X-lanni/Tinker/1.Bom/README.md

# Tinker
## _Flexible, and Ready to Move: Your Cartoon-Style Bipedal Robot!_ 
Tinker is primarily built using 3D printing and carbon fiber cutting. To ensure structural rigidity, some parts use aluminum alloy cuts. The entire robot runs on 24V power and can be manually assembled. You can process the Tinker kit based on the list below or purchase a pre-assembled kit from the official RoboHome store:  
[Official RoboHome Store](https://shop124436104.taobao.com/?spm=pc_detail.29232929/evo365560b447257.shop_block.dshopinfo.2e687dd6BnZIzR)

## Material List

| Item | Specification | Link | Price (RMB) |
|---|---|---|---|
| Router | Black 1 Ethernet port + PFC antenna | https://item.taobao.com/item.htm?id=636099840850&spm=a1z10.1-c-s.w4004-22912785476.34.28113d0etvlbTQ | 82 |
| Handle<br> | Color classification: diameter 20 hole distance 75MM silver | https://detail.tmall.com/item.htm?id=648984641196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.. | 25 |
| Handle 1 | 100mm spacing | https://detail.tmall.com/item.htm?id=649810911512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 | 12.5 |
| Battery | Color classification: 6s1865:24v7ah rectangular/38-70-110 mm<br> | https://item.taobao.com/item.htm?id=620559361552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 | 199 |
| DCDC | 7.4V | https://item.taobao.com/item.htm?_u=31klsj89a707&id=601763884843&spm=a1z09.2.0.0.35152e8dtsNMeP | 42 |
| DCDC | 5V | https://item.taobao.com/item.htm?_u=31klsj89a707&id=601763884843&spm=a1z09.2.0.0.35152e8dtsNMeP | 42 |
| 6006 motor | 4 of them. | https://item.taobao.com/item.htm?id=816922353459&spm=a21xtw.29178619.product_shelf.8.4e127fe0pb8Ghr | 799 |
| 8006 motor | 6 of them. | https://item.taobao.com/item.htm?id=815097170248&spm=a21xtw.29178619.product_shelf.15.4e127fe0pb8Ghr | 1009 |
| Robot main controller<br> | 1 | https://item.taobao.com/item.htm?id=643604114830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 | 899 |
| Jumper conversion module | 1.USB 2.0 female socket to DIP<br> | https://detail.tmall.com/item.htm?id=520458685405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 | 15 |
| Distribution board | 1 | With step-down module | 200 |
| Carbon fiber cutting | 1 set | See below | Inquiry |
| Aluminum alloy processing | 1 set | See below | Inquiry |
| 3D printing | 1 set | See below | Inquiry |
| TF card | 64G 2 pieces<br> | https://detail.tmall.com/item.htm?id=44499258098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 | 32 |
| Servo brushlessSCS40 | 2 | https://item.taobao.com/item.htm?id=561810277224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 | 386 |
| Steering gear SCS125(Can be upgraded to 40 to improve head flexibility) | 1 | https://item.taobao.com/item.htm?id=648615972680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 | 85 |
| Steering gear drive plate | 1 | https://item.taobao.com/item.htm?id=560546097733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 | 45 |
| JetsonNano | Single main board | https://detail.tmall.com/item.htm?id=608609593274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 | 1119 |
| Network cable | 3.Length: 0.25m Color Classification: Upper Bend, Super Category 6 Thin Line | https://detail.tmall.com/item.htm?id=624570157854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 | 6.8 |
| Remote control | 1.Bat 2 black [high-end version] with vibration | https://detail.tmall.com/item.htm?id=38896089959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 | 77 |
| Ethernet port conversion | Shielded D-type straight-through socket (1 piece) | https://detail.tmall.com/item.htm?id=674427182363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 | 20.8 |
| Sleeve | Black large size (adult size) [ (length 33 width 20cm) ] 2 pieces | https://item.taobao.com/item.htm?id=683955453468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 | 13 |
| Foot cushioning | Thick 15 wide 40 | https://detail.tmall.com/item.htm?id=740214426088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 | 11 |
| Air switch | Single 32A | https://buyertrade.taobao.com/trade/detail/tradeSnap.htm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 | 31 |
| Pressure reduction module | 5V | https://item.taobao.com/item.htm?id=544179516749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 | 23 |

## Screw and Nut

| Screen | Link | Number | Usage |
|---|---|---|---|
| M3*6<br> | https://detail.tmall.com/item.htm?id=635430936636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 | 20 | Top motor mounting |
| M3*6 | | 10 | Fixed aluminum alloy for rolling motor |
| M4*8 | | 10 | Fixed aluminum alloy for rolling motor |
| M4*8 | | 10 | Thigh aluminum roll motor |
| M4*8 | | 10 | Thigh aluminum alloy thigh motor |
| M3*6 | | 28 | Thigh carbon plate |
| M3*10 | | 6 | Thigh carbon plate and support |
| M4*6 | | 10 | Calf carbon plate, calf motor |
| M3*10 | | 8 | Calf carbon plate and support |
| M3*6 | | 10 | Ankle joint motor and carbon plate |
| M3*8 | | 12 |  Ankle joint motor and foot end |
| M3*15 | | 8 |  Upper and lower racks and supports |
| M3*10 | | 6 | Battery compartment |
| M5*15 | | 4 | Bottom support |
| M3*12 | | 2 | Battery top fixing |
| M3*10 | | 4 | Battery side fixing |
| M3*6 | | 4 |  Main control carbon plate support |
| M3*8 | |  4 |  Power supply plate fixing |
| M2.5 aluminum column * 12 | https://item.taobao.com/item.htm?id=521616041424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  | 4 | Main control plate support |
| M2.5*5 | https://item.taobao.com/item.htm?id=521623593151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..  | 4 | Main control carrier board |
| M2.5*10 | |  4 | Main control carrier bottom |
| M3*12 | |  4 |  JetsonNano |
| M3*10 | |  8 |  Router, servo drive |
| M4*15 | | 10 | Head servo fixation |
| M3*8 | | 15 | Head servo |
| M3 nut self-locking | https://item.taobao.com/item.htm?id=9558815975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 | Above sum | |
| | | | |

## Cable
| Type | Link | Number |
|---|---|---|
| Red and black power extension cable16AW | https://item.taobao.com/item.htm?id=597502950509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 | 2 meters |
| XT30 female head16AW<br> | https://item.taobao.com/item.htm?id=598407253999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 | 8 |
| XT30 male head16AW | |8 |
| 4P 2.0 line | https://item.taobao.com/item.htm?id=520551443113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. | 6 |
| 4P 1.25 line 20cm | https://item.taobao.com/item.htm?id=588775918268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 | 4 |
| Double head 10cm 4p Same face | https://detail.tmall.com/item.htm?id=550579148901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 | 2 |
| Double head 10cm 4p different surface | | 2 |
| DC head 0.1m | https://detail.tmall.com/item.htm?id=598354258377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 | 2 |

## Carbon fiber cutting
V1：[Click here to view the folder](https://drive.google.com/drive/folders/1KnC-RKWRdck51djY4cLO2_fAsvc746Mc?usp=drive_link)

Carbon plate cutting includes the following content, among which the marked X needs to be processed according to the number, and the last two need to be cut 0.5mm on each side to ensure installation:
<div align="center">


</div>
<div align="center">

</div>

## Aluminum alloy processing
V1：[Click here to view the folder](https://drive.google.com/drive/folders/1Rvp5F-ukXmW73BvD4d4sHrTAwg58c-pP?usp=drive_link)

Aluminum alloy processing is as follows: hip processing 2, thigh processing according to symmetry 1 positive and 1 negative 2
<div align="center">

</div>

## 3D printing
V1: [Click here to view the folder](https://drive.google.com/drive/folders/12IBDAVzblmIEFn6BoeleFhU9YEcTEuLw?usp=drive_link)

3D printing processing is as follows: DC represents the need to print 1 positive and 1 negative, and the corresponding number of other numbers marked separately:
<div align="center">

</div>

## PCB processing (optional)
V1：[Click here to view the folder](https://drive.google.com/drive/folders/1OVtjc0a6-6FSMaonkhxavuNPwOWzWQmY?usp=drive_link)

PCB processing includes the following, and controller kits can also be purchased directly from [RoboHome](https://item.taobao.com/item.htm?id=643604114830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)
<div align="center">

</div>
