X-lanni/Tinker/2.Assemble/Hardware/pcb原理图/PCB-20241204T155450Z-001/PCB/人形分电.PcbDoc.htm

Reporting Options

# File in Previous Format

Date | : | 2024/12/4
Time | : | 23:57:12
Filename | : | D:\GitHub_Project\Tinker\assemble\结构\pcb原理图\PCB-20241204T155450Z-001\PCB\人形分电.PcbDoc

Version | Warning
Release 12 | CAUTION - Air Gap Width previously controlled by Clearance rule is now controlled by Polygon Connect Style rule's newly introduced Air Gap Width (set to default value). Suggest reviewing each Polygon Connect Style rule's Air Gap Width attribute for correctness.
Release 13 | CAUTION - Silkscreen Over Component Pads Rules are converted to Silk To Solder Mask Clearance Rules. Suggest examining rule scopes for accuracy.

This file was generated by an earlier version of the software
