X-lanni/Tinker/4.Development/LocomotionWithNP3O-masteroldx/lcm/lcm-java/jchart2d-code/doc/img/architecture.png

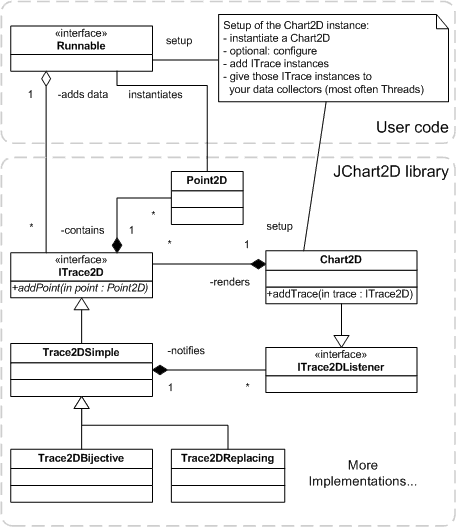
4.Development/LocomotionWithNP3O-masteroldx/lcm/lcm-java/jchart2d-code/doc/img/architecture.png
