X-lanni/Tinker/4.Development/LocomotionWithNP3O-masteroldx/lcm/lcm-java/jchart2d-code/doc/img/Client-Screenshot.gif

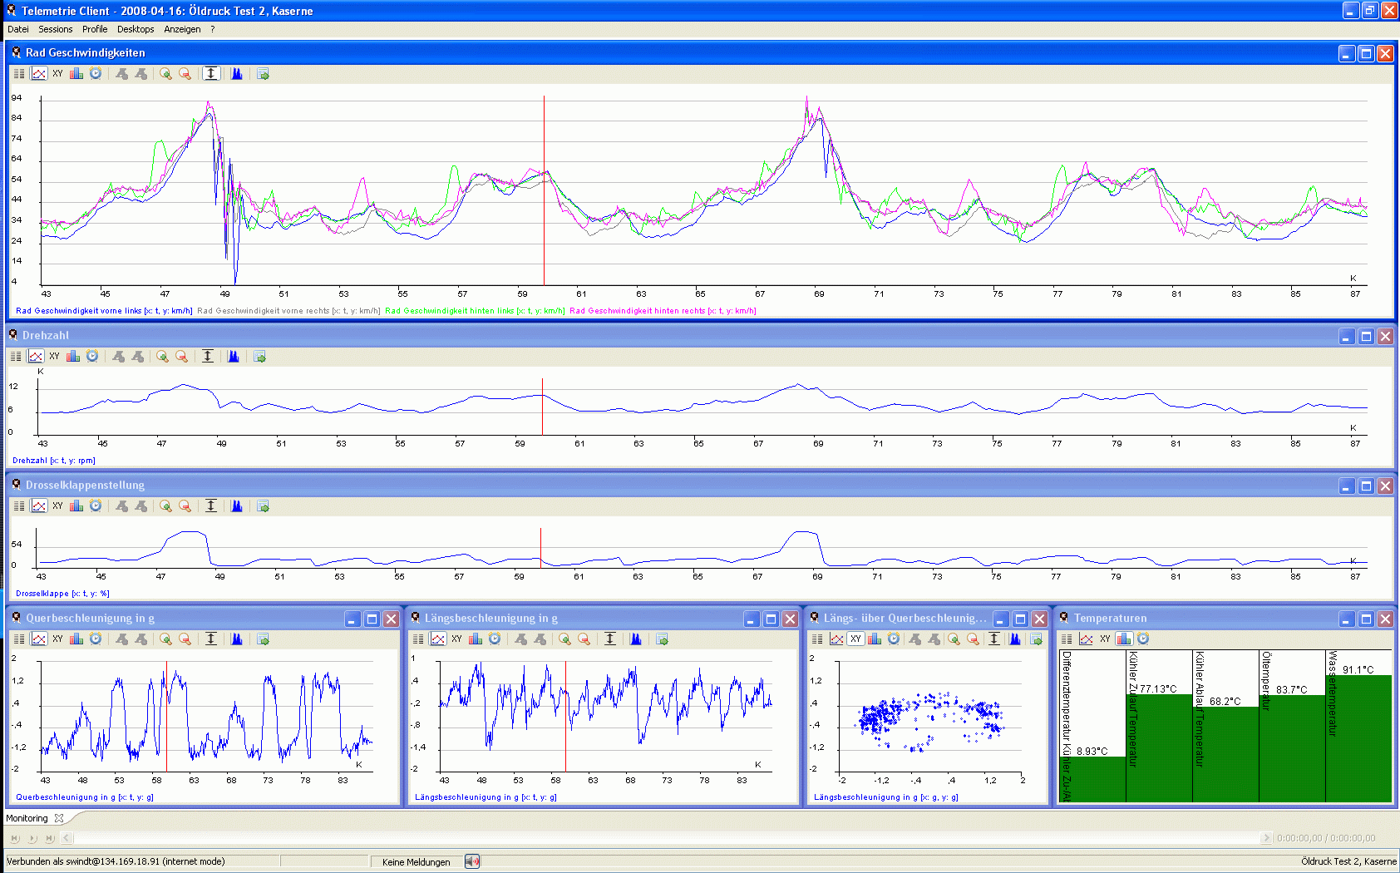
4.Development/LocomotionWithNP3O-masteroldx/lcm/lcm-java/jchart2d-code/doc/img/Client-Screenshot.gif
