X-lanni/Tinker/4.Development/LocomotionWithNP3O-masteroldx/lcm/lcm-java/jchart2d-code/doc/img/saison_2008_lr08_fahrwerk_001_1_20080530_1194722016.jpg

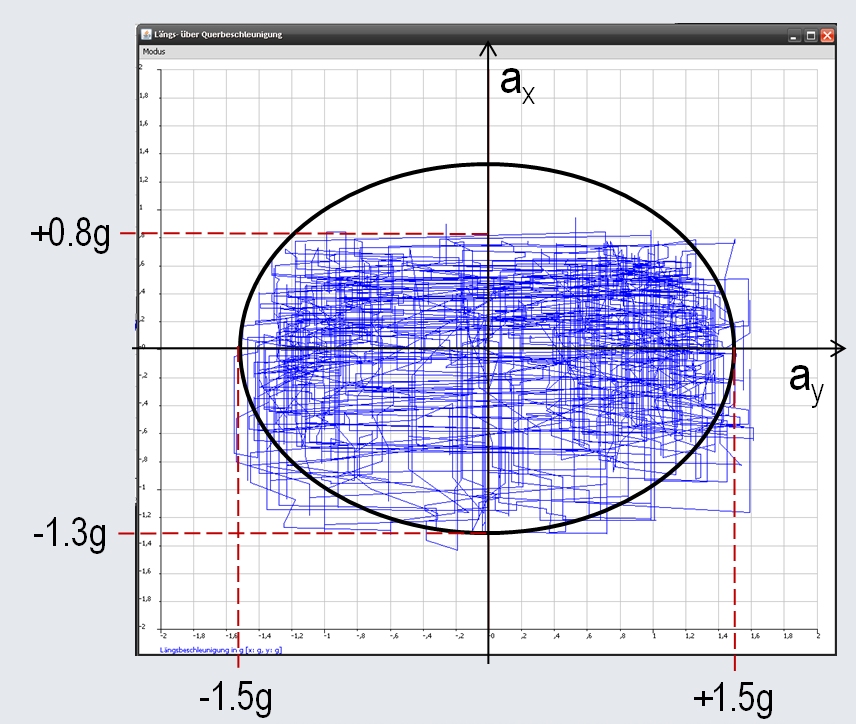
4.Development/LocomotionWithNP3O-masteroldx/lcm/lcm-java/jchart2d-code/doc/img/saison_2008_lr08_fahrwerk_001_1_20080530_1194722016.jpg
