X-lanni/Tinker/5.Docs/images/0/whiteboard_ug1.png

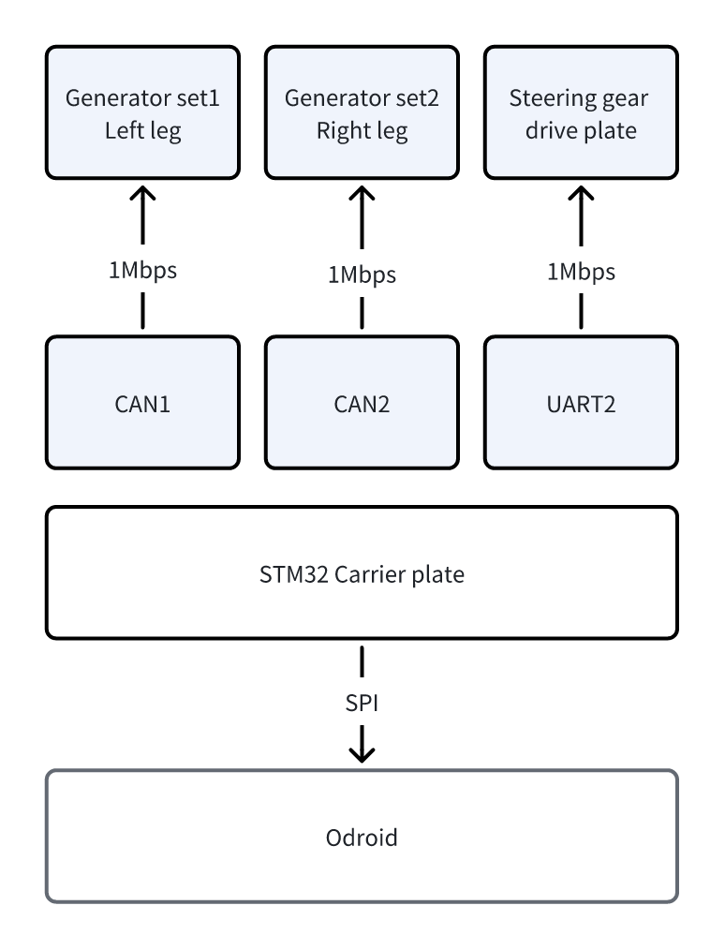
5.Docs/images/0/whiteboard_ug1.png
