X-lanni/Tinker/5.Docs/images/development/1.PNG

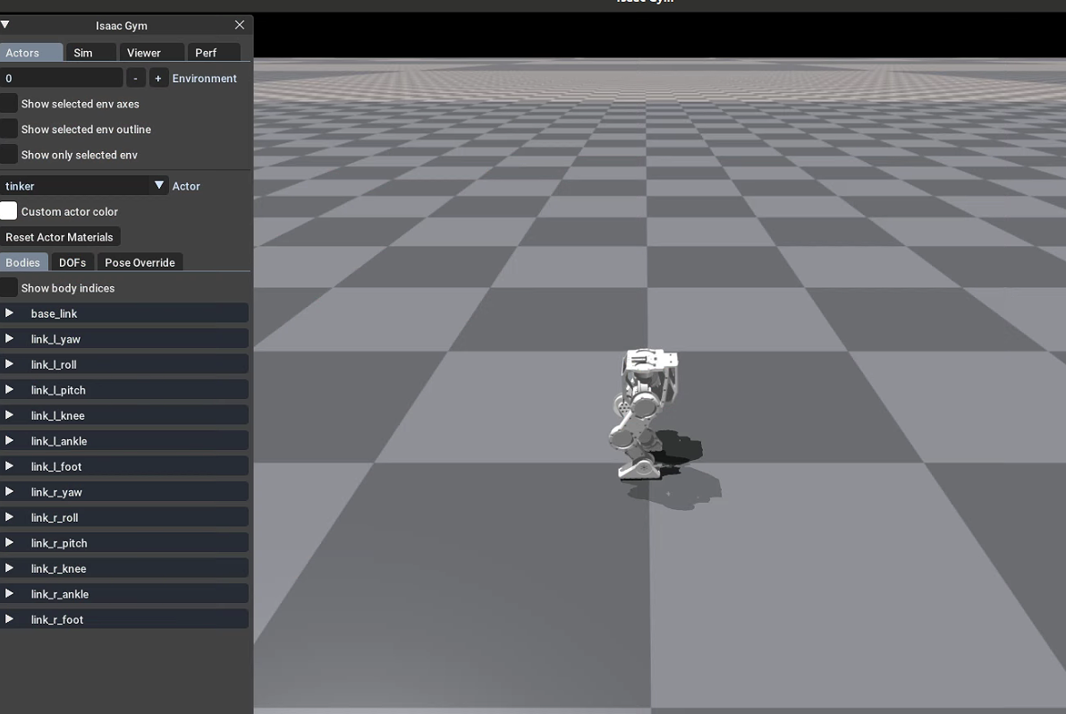
5.Docs/images/development/1.PNG
