X-lanni/Tinker/5.Docs/images/development/2.PNG

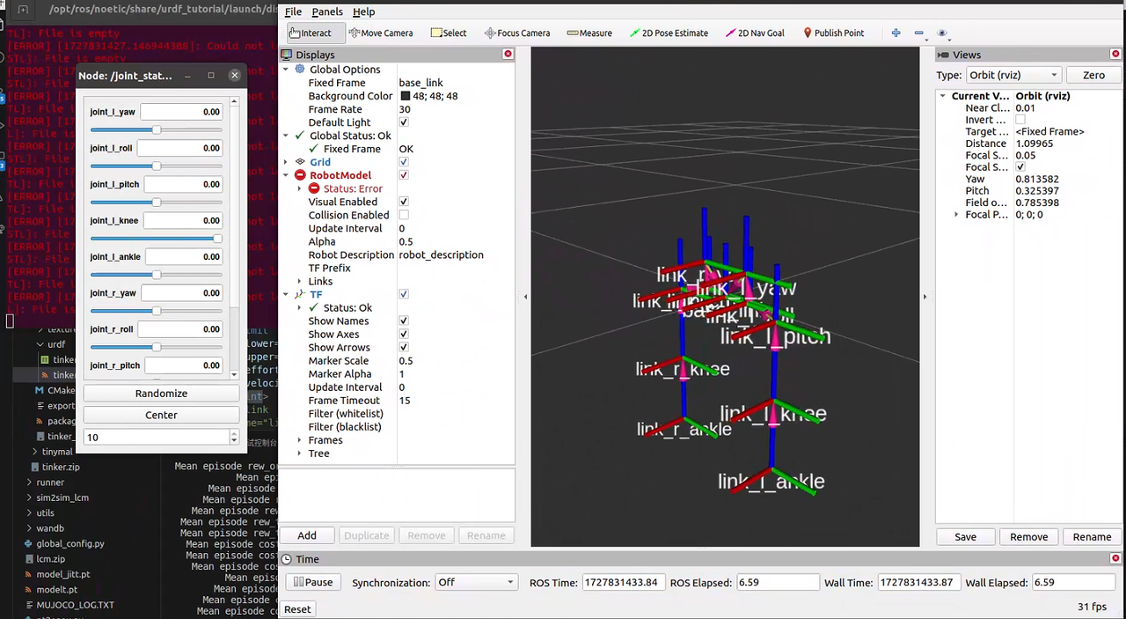
5.Docs/images/development/2.PNG
