X-lanni/Tinker/5.Docs/images/development/3.png

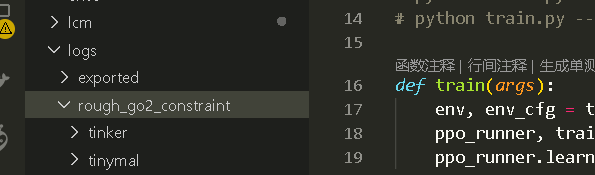
5.Docs/images/development/3.png
