X-lanni/Tinker/5.Docs/images/development/4.png

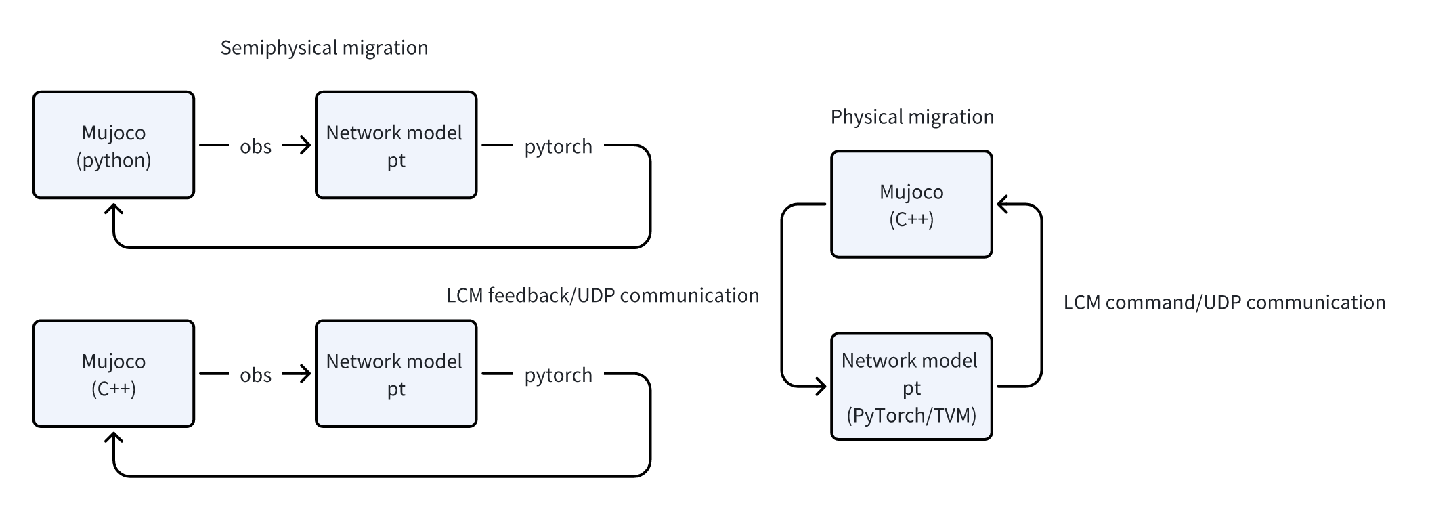
5.Docs/images/development/4.png
