X-lanni/Tinker/5.Docs/images/development/5.png

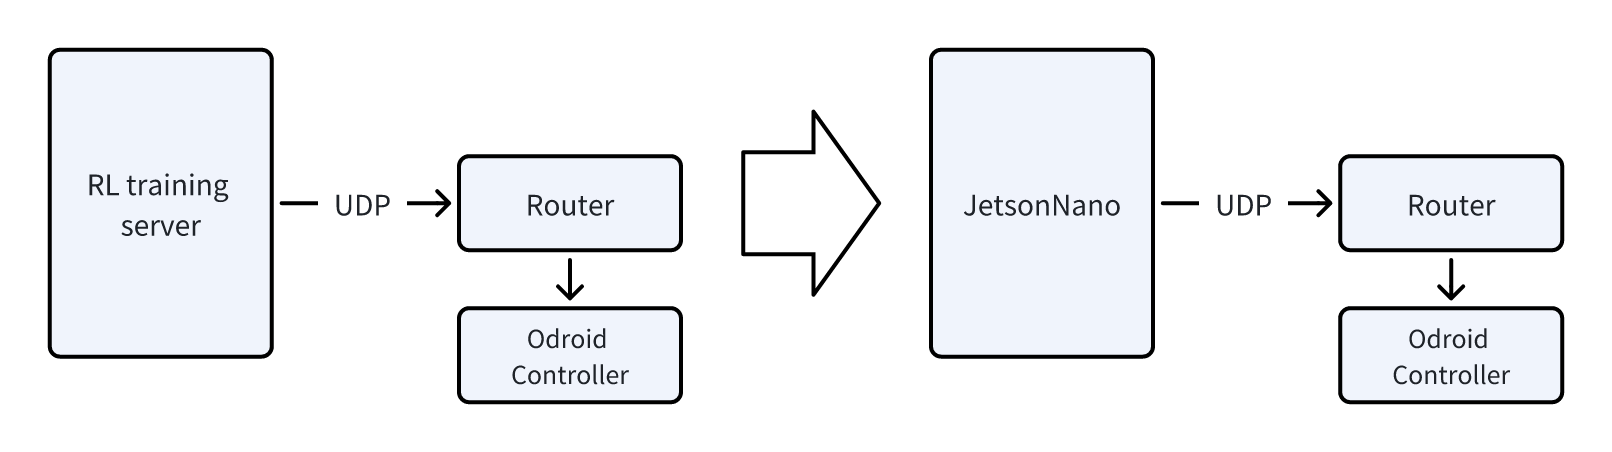
5.Docs/images/development/5.png
