X-lanni/Tinker/5.Docs/images/t01.JPG

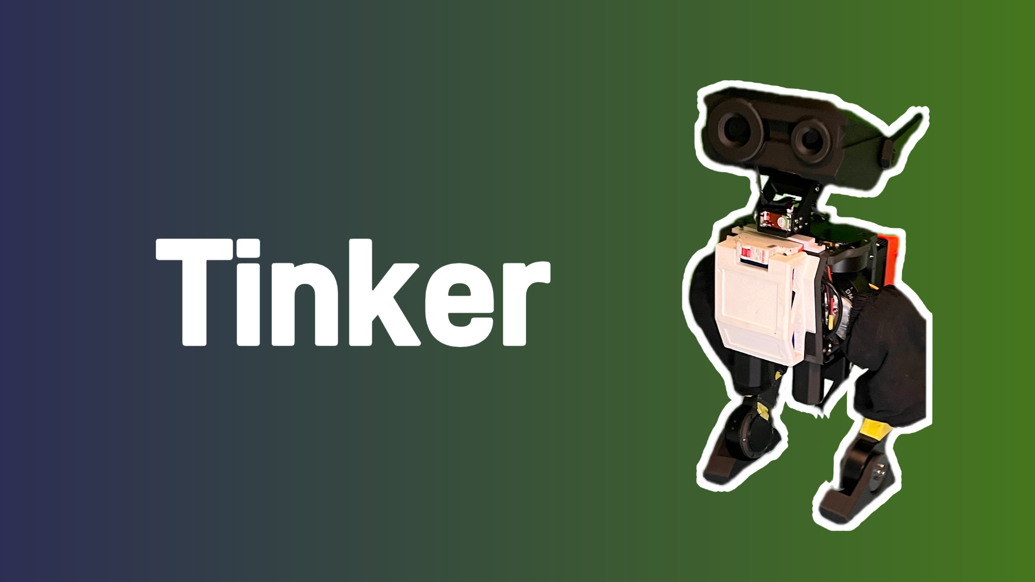
5.Docs/images/t01.JPG
