X-lanni/Tinker/5.Docs/images/videos/24fp.png

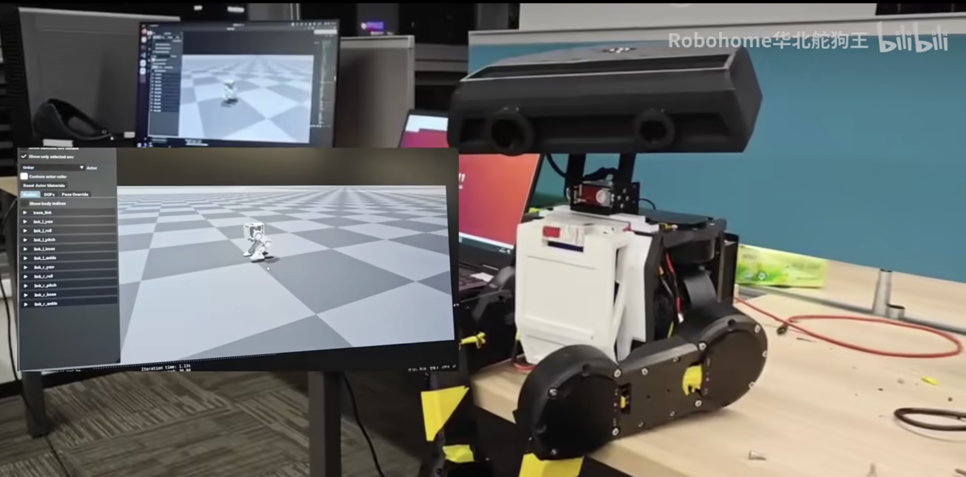
5.Docs/images/videos/24fp.png
