X-lanni/Tinker/2.Assemble/Hardware/pcb原理图/PCB-20241204T155450Z-001/PCB/人形分电.xls

Comment | Description | Designator | Footprint | Quantity
Header 2 | BAT1为母头 其他为公头 | BAT1, BAT2, BAT3, BAT4, BAT5, LEG1, LEG2, LEG3, LEG4 | XT30UPB | 9
Header 2X2 | 2.54排针 | DCDC1, DCDC2 | DCDC5V | 2
LED1 | LED红色 | DS2 | SMDLED | 1
100K | 0603 | R1 | R0805 | 1
560R | 0603 | R2 | R0603 | 1
10K | 0603 | R3 | R0805 | 1
