X-lanni/Tinker/2.Assemble/Hardware/pcb原理图/PCB-20241204T155450Z-001/PCB/载板V2.xls

Comment | Description | Designator | Footprint | Quantity
Header 2 | XH2.54卧插端子 带锁 | BAT1 | HDR1X2 | 1
BEEP | 蜂鸣器 | BEEP? | DET402 | 1
Header 2 | 轻触按键 | BOOT1 | 663*4*2.0/2.5mm | 1
0.1UF | 电容 | C1, C9, C11, C12, C14, C15, C16, C17, C18, C21, C24, C25 | C 0402 | 12
1UF | 电容 | C2 | C 0402 | 1
2.2UF | 电容 | C3, C4 | C0603 | 2
10NF | 电容 | C5 | C 0402 | 1
20PF | 电容 | C6, C7 | C 0402 | 2
0.1UF | 电容 | C8, C19, C20 | C0603 | 3
10uF | 电容 | C10, C13 | C0603 | 2
100uF | 电容 | C27 | C0805 | 1
Header 4 | PH2.0立端子 | CAN1, CAN2, CAN3, CAN4 | PH2.0-4SMT | 4
BAT54WS | 单肖特基二极管 | D1 | SOD-323 | 1
PESD1CAN |  | D2, D3 | SOT-23 | 2
Header 3 | 不焊接 | DBUS1, SBUS | HDR1X3 | 2
Header 2X2 | 不焊接 | DCDC1 | DCDC5V | 1
LED1 | LED蓝色 | DS1, DS2 | SMDLED | 2
ICM20602 |  | ICM1 | ICM20602 | 1
Header 4 | 立贴端子 | IDLE1, RADIO1 | JST_GH_V4 | 2
MSK-12D19 | 立开关三档 | KEY | HDR1X3 | 1
Header 5 | 2.54母座 | P2 | HDR1X5 | 1
Header 4 | 2.54母座 | P3 | HDR1X4 | 1
Header 3 | 立贴端子 | P10 | JST_GH_V3 | 1
Header 7X2 | 2.54排针 | PIO | HDR2X7 | 1
S8050 | 8050/BCW846/BCW847 | Q1, Q2 | SOT-23R | 2
10K | 电阻 | R1, R2, R3, R4, R7, R10, R11 | R0603 | 7
560R | 电阻 | R5, R20 | R0603 | 2
1K | 电阻 | R6 | R0603 | 1
100R | 电阻 | R8, R9 | R0603 | 2
120R | 电阻 | R12, R17 | R0603 | 2
100K | 电阻 | R18 | R0805 | 1
10K | 电阻 | R19 | R0805 | 1
360R | 电阻 | R21, R22 | R 0402 | 2
120R | 电阻 | R23 | R 0402 | 1
Header 2 | 侧轻触按钮 | RST | KEY_SAD | 1
Header 4 | 立贴端子 | SWD1, USB_L1 | SH1.0-4P - UP | 2
STM32F405RGT6 |  | U1 | LQFP64_M | 1
W25X16 | W25X16;SST25VF016;MX25L1605 | U2 | W25Q32FVZPIG | 1
TJA1050 |  | U3, U4 | SOP-8 | 2
SP3485 |  | U5 | SOP-8 | 1
RT9193-3.3/LP2985/SPX3819 | 降压IC | V1 | SOT23-5 | 1
8MHZ | Crystal Oscillator | X1 | PXCL | 1
