X-lanni/Tinker/5.Docs/images/bom/b1.jpeg

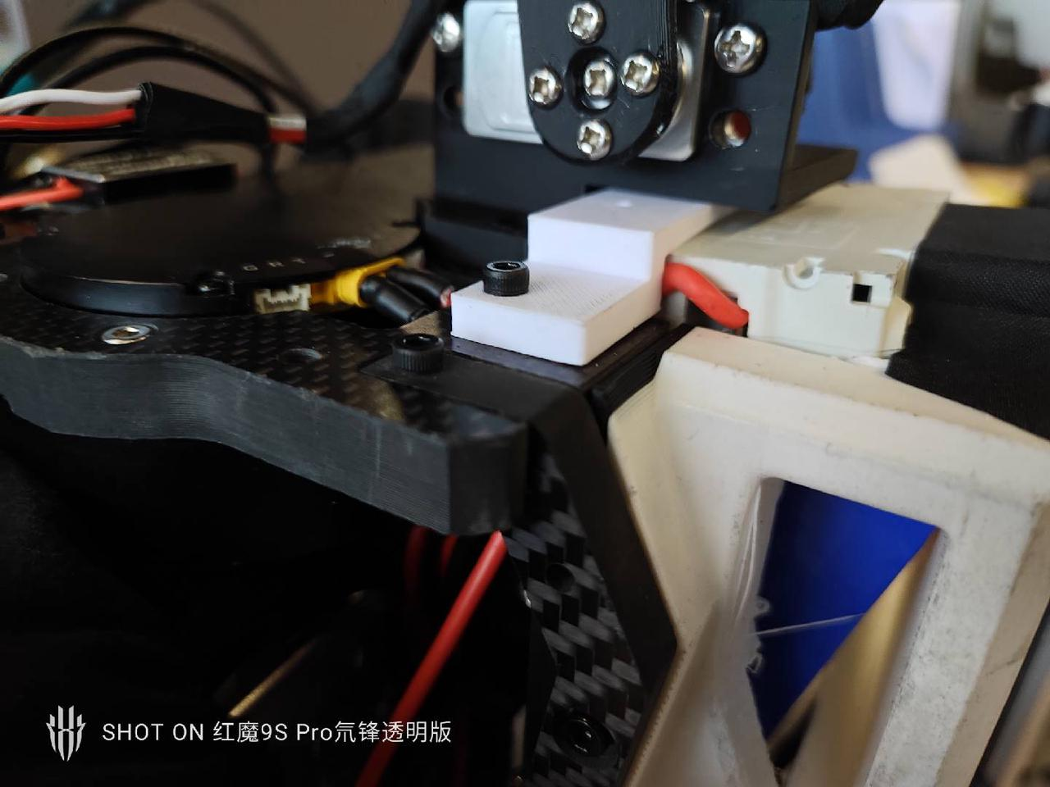
5.Docs/images/bom/b1.jpeg
