X-lanni/Tinker/5.Docs/images/bom/b2.png

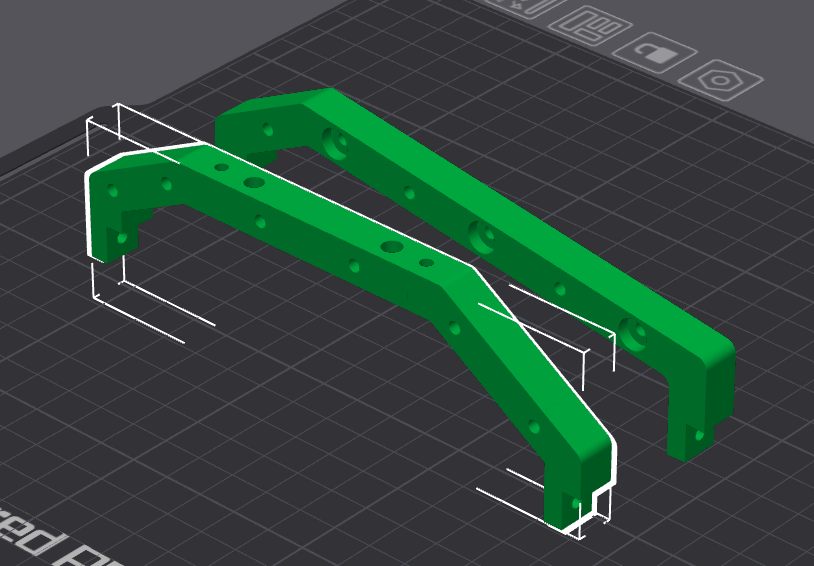
5.Docs/images/bom/b2.png
