X-lanni/Tinker/5.Docs/images/bom/b3.png

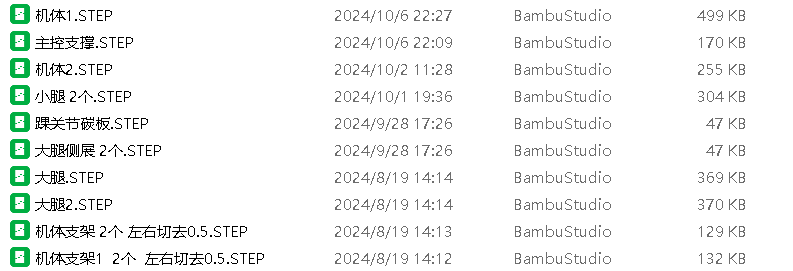
5.Docs/images/bom/b3.png
