X-lanni/Tinker/5.Docs/images/bom/b4.png

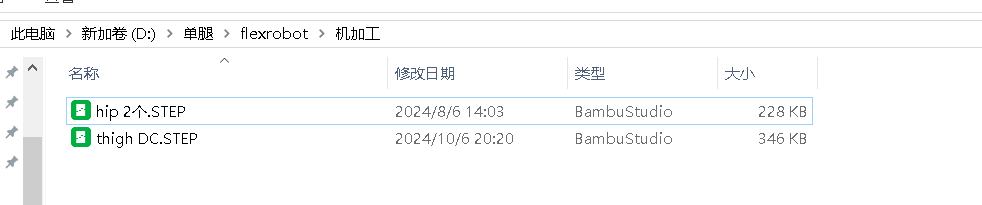
5.Docs/images/bom/b4.png
