X-lanni/Tinker/5.Docs/images/bom/b5.png

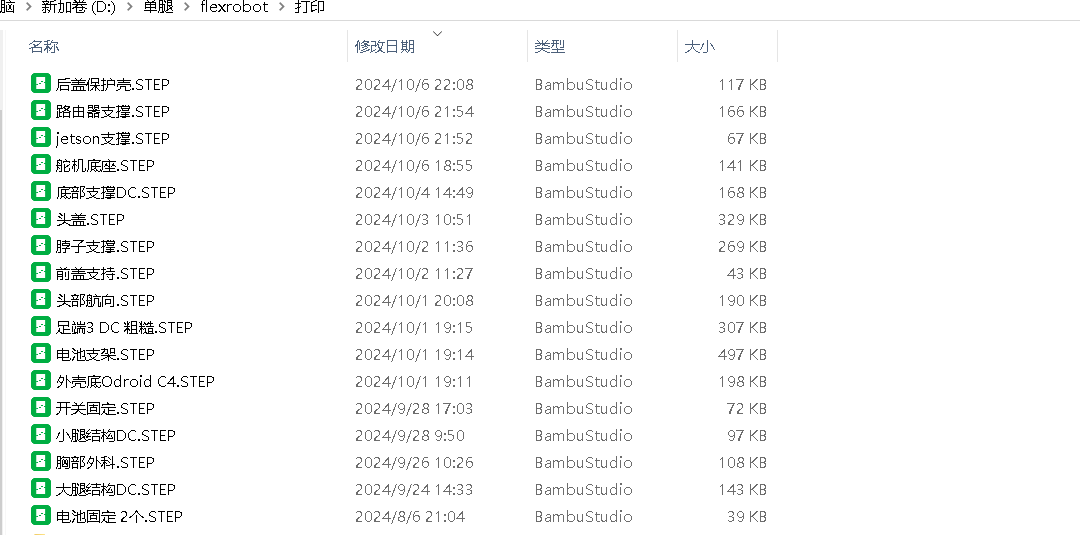
5.Docs/images/bom/b5.png
