X-lanni/Tinker/5.Docs/images/bom/b6.png

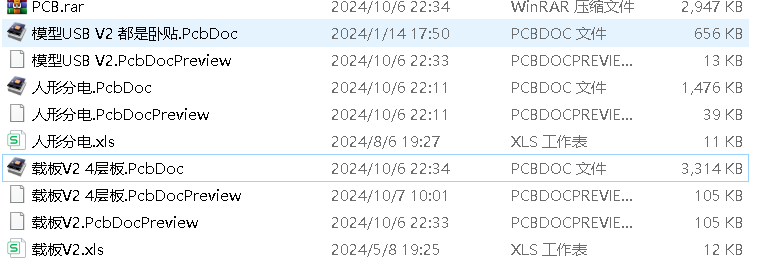
5.Docs/images/bom/b6.png
