X-lanni/Tinker/2.Assemble/Hardware/3d打印件/print-20241204T155423Z-001/print/胸部外科.STEP

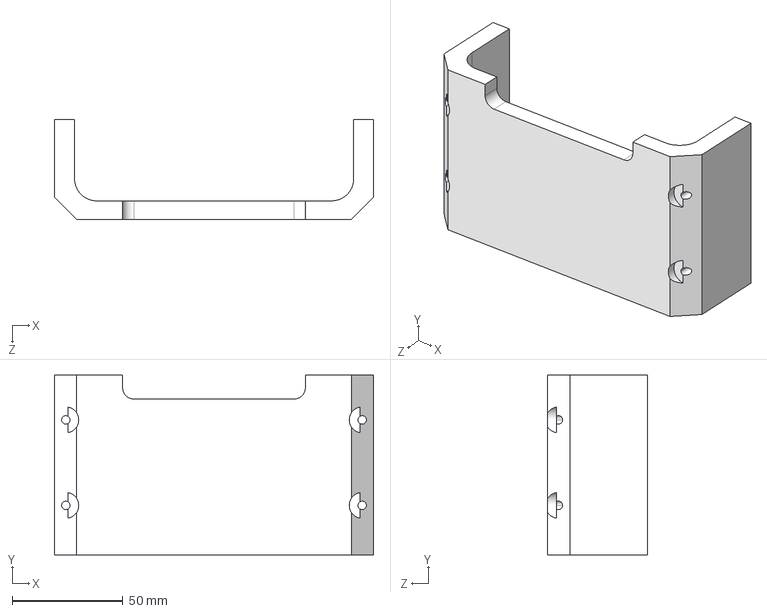
[picture p33: CAD file, 2025-03-02]
2.Assemble/Hardware/3d打印件/print-20241204T155423Z-001/print/胸部外科.STEP
143.8 x 81.1 x 45.0 mm
