X-lanni/Tinker/2.Assemble/Hardware/碳钎维加工/cut-20241204T155151Z-001/cut/小腿 2个.STEP

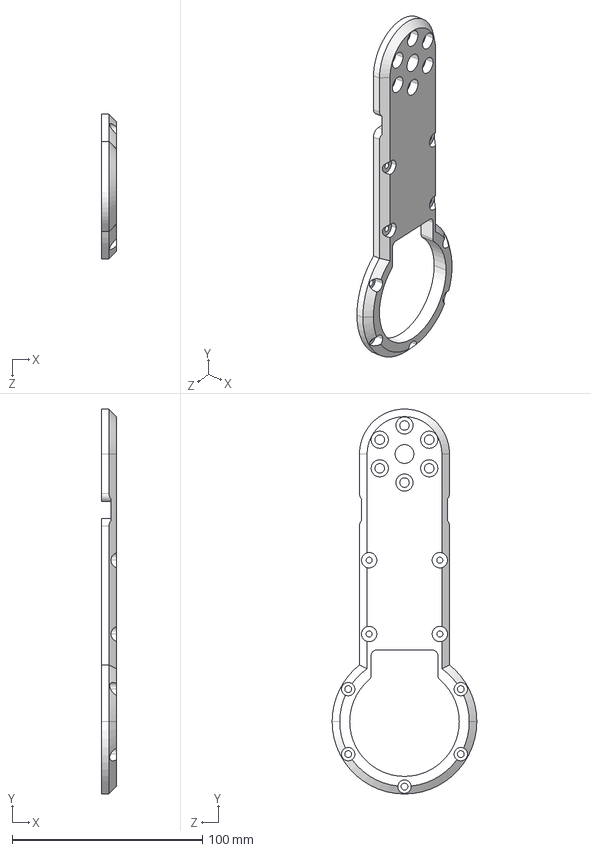
[picture p34: CAD file, 2025-03-02]
2.Assemble/Hardware/碳钎维加工/cut-20241204T155151Z-001/cut/小腿 2个.STEP
8.00 x 202.1 x 76.0 mm
