X-lanni/Tinker/2.Assemble/Hardware/铝合金加工/machining-20241204T155329Z-001/machining/thigh DC.STEP

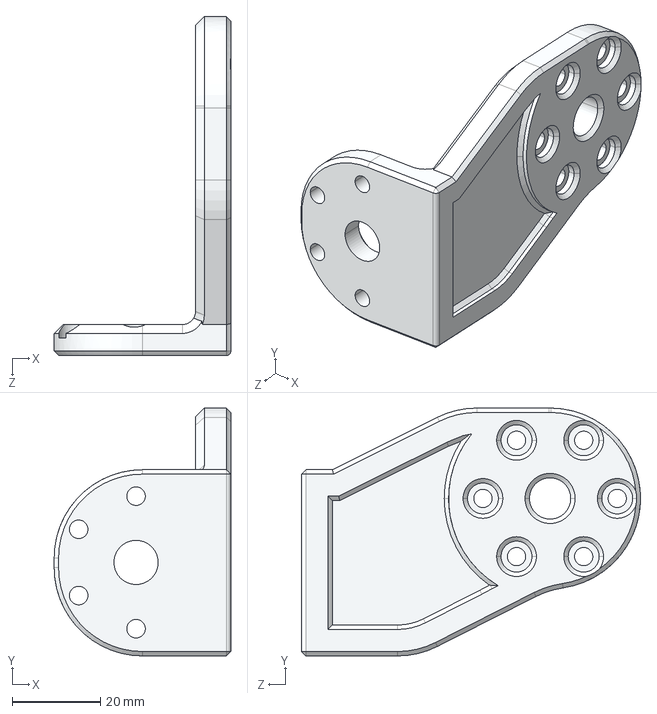
[picture p35: CAD file, 2025-03-02]
2.Assemble/Hardware/铝合金加工/machining-20241204T155329Z-001/machining/thigh DC.STEP
40.0 x 56.1 x 76.7 mm
