X-lanni/Tinker/4.Development/LocomotionWithNP3O-masteroldx/resources/tinker/meshes/base_link.STL

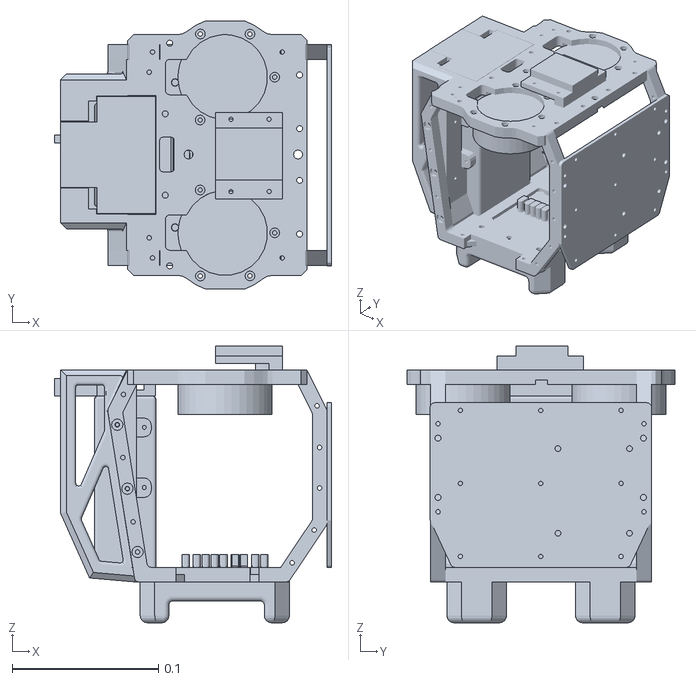
[picture p36: CAD file, 2025-03-02]
4.Development/LocomotionWithNP3O-masteroldx/resources/tinker/meshes/base_link.STL
0.19 x 0.184 x 0.189
