X-lanni/Tinker/4.Development/LocomotionWithNP3O-masteroldx/resources/tinymal/meshes/RR_foot.STL

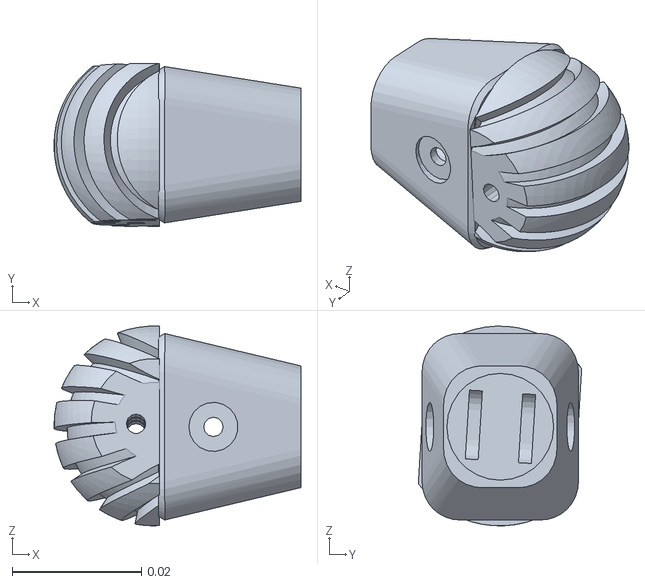
[picture p37: CAD file, 2025-03-02]
4.Development/LocomotionWithNP3O-masteroldx/resources/tinymal/meshes/RR_foot.STL
0.0382 x 0.0252 x 0.0308
