X-lanni/Tinker/4.Development/tinker/meshes/link_l_pitch.STL

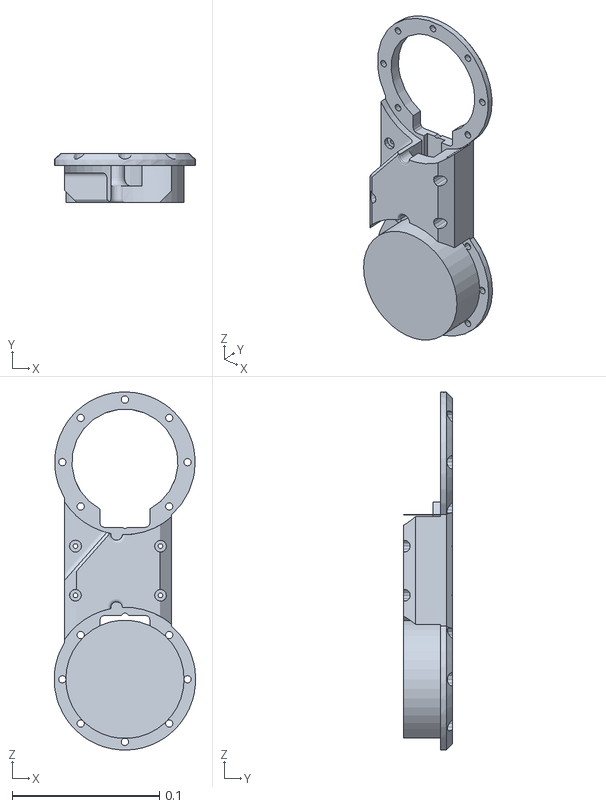
[picture p38: CAD file, 2025-03-02]
4.Development/tinker/meshes/link_l_pitch.STL
0.096 x 0.033 x 0.243
