X-lanni/Tinker/2.Assemble/Hardware/3d打印件/print-20241204T155423Z-001/print/外壳底Odroid C4.STEP

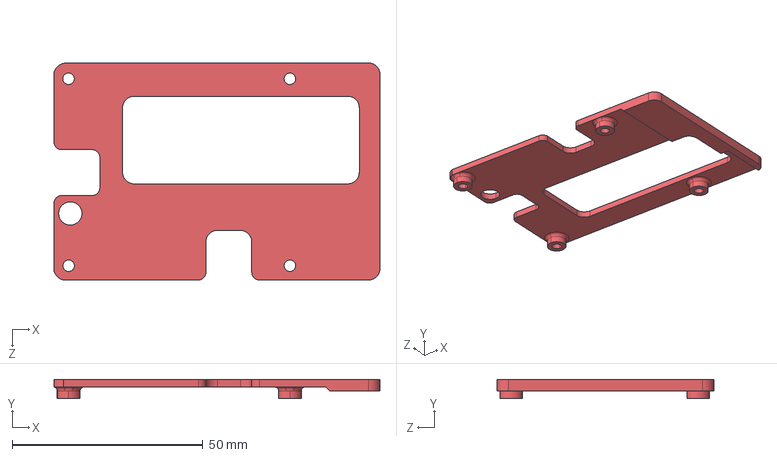
[picture p39: CAD file, 2025-03-02]
2.Assemble/Hardware/3d打印件/print-20241204T155423Z-001/print/外壳底Odroid C4.STEP
85.4 x 5.00 x 56.9 mm
