X-lanni/Tinker/2.Assemble/Hardware/碳钎维加工/cut-20241204T155151Z-001/cut/大腿.STEP

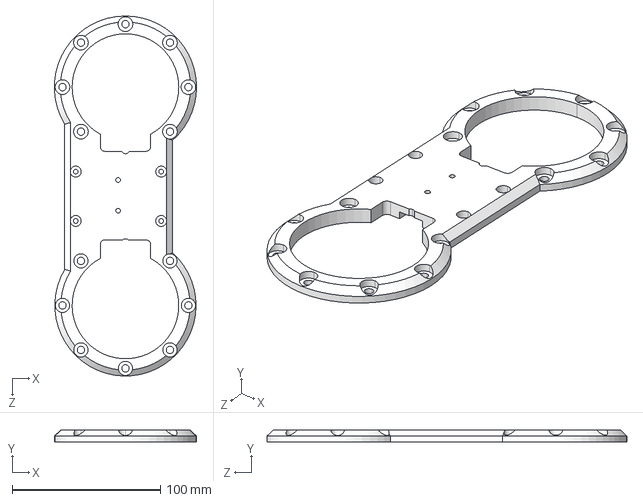
[picture p40: CAD file, 2025-03-02]
2.Assemble/Hardware/碳钎维加工/cut-20241204T155151Z-001/cut/大腿.STEP
96.0 x 8.00 x 243.1 mm
