X-lanni/Tinker/2.Assemble/Hardware/铝合金加工/machining-20241204T155329Z-001/machining/hip 2个.STEP

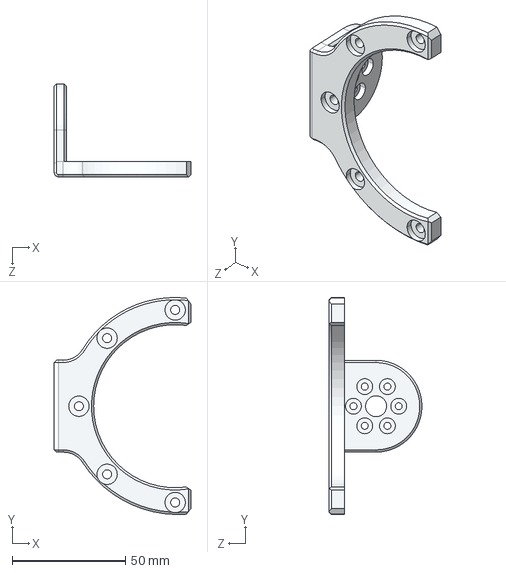
[picture p41: CAD file, 2025-03-02]
2.Assemble/Hardware/铝合金加工/machining-20241204T155329Z-001/machining/hip 2个.STEP
60.3 x 95.8 x 41.0 mm
