X-lanni/Tinker/4.Development/LocomotionWithNP3O-masteroldx/resources/tinker/meshes/link_r_yaw.STL

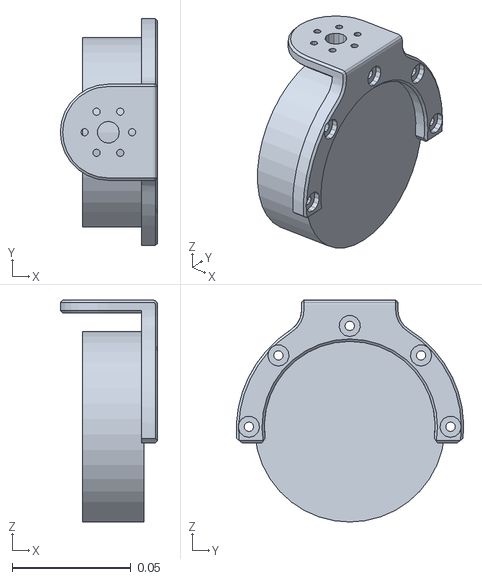
[picture p42: CAD file, 2025-03-02]
4.Development/LocomotionWithNP3O-masteroldx/resources/tinker/meshes/link_r_yaw.STL
0.041 x 0.0958 x 0.0936
