X-lanni/Tinker/4.Development/LocomotionWithNP3O-masteroldx/resources/tinymal/meshes/RR_hip.STL

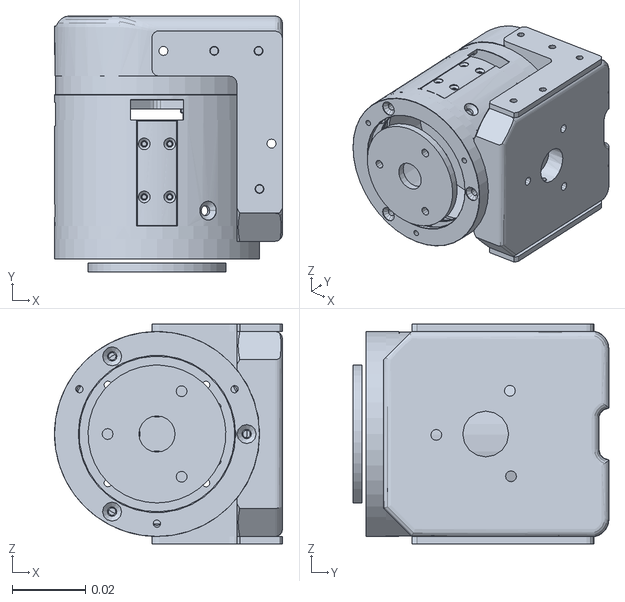
[picture p43: CAD file, 2025-03-02]
4.Development/LocomotionWithNP3O-masteroldx/resources/tinymal/meshes/RR_hip.STL
0.0623 x 0.0699 x 0.06
