X-lanni/Tinker/4.Development/tinker/meshes/link_r_knee.STL

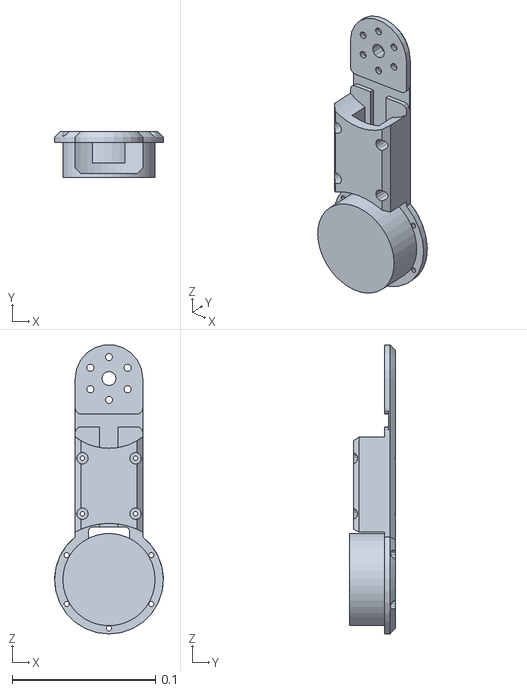
[picture p44: CAD file, 2025-03-02]
4.Development/tinker/meshes/link_r_knee.STL
0.076 x 0.0325 x 0.202
