X-lanni/Tinker/2.Assemble/Hardware/3d打印件/print-20241204T155423Z-001/print/头部航向.STEP

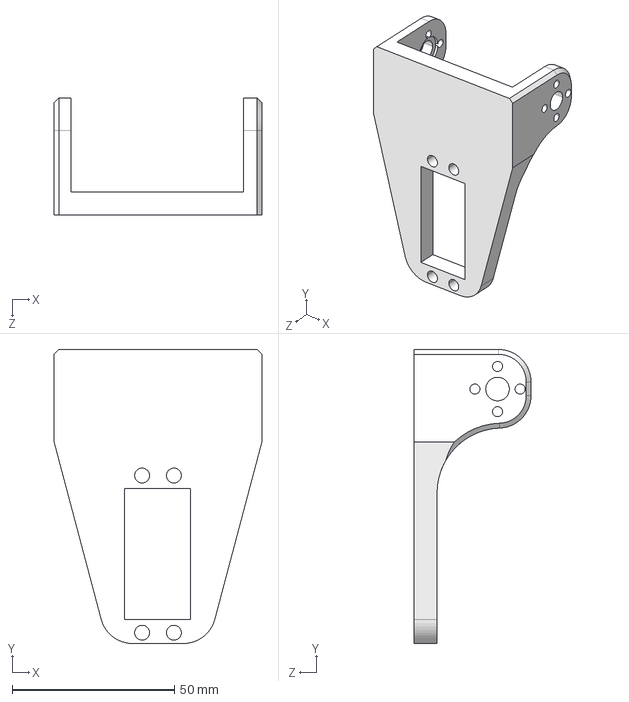
[picture p45: CAD file, 2025-03-02]
2.Assemble/Hardware/3d打印件/print-20241204T155423Z-001/print/头部航向.STEP
64.0 x 90.6 x 36.1 mm
