X-lanni/Tinker/2.Assemble/Hardware/碳钎维加工/cut-20241204T155151Z-001/cut/机体支架 2个 左右切去0.5.STEP

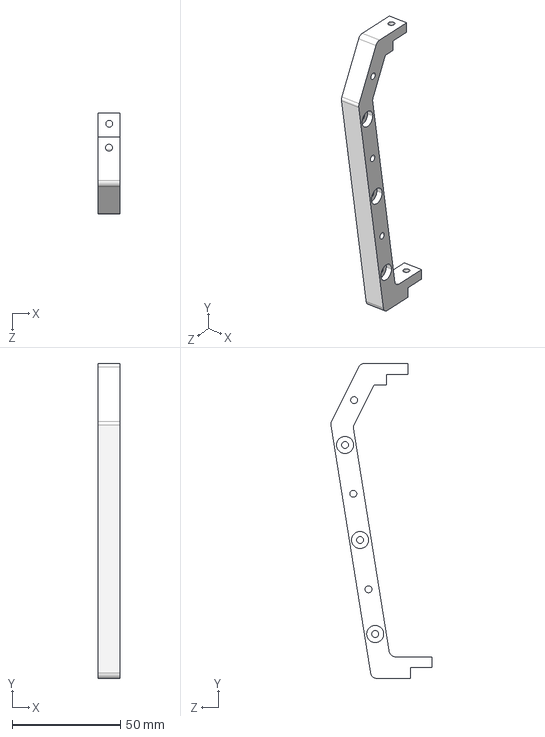
[picture p46: CAD file, 2025-03-02]
2.Assemble/Hardware/碳钎维加工/cut-20241204T155151Z-001/cut/机体支架 2个 左右切去0.5.STEP
10.0 x 145.2 x 46.7 mm
