X-lanni/Tinker/4.Development/LocomotionWithNP3O-masteroldx/resources/tinymal/meshes/FR_calf.STL

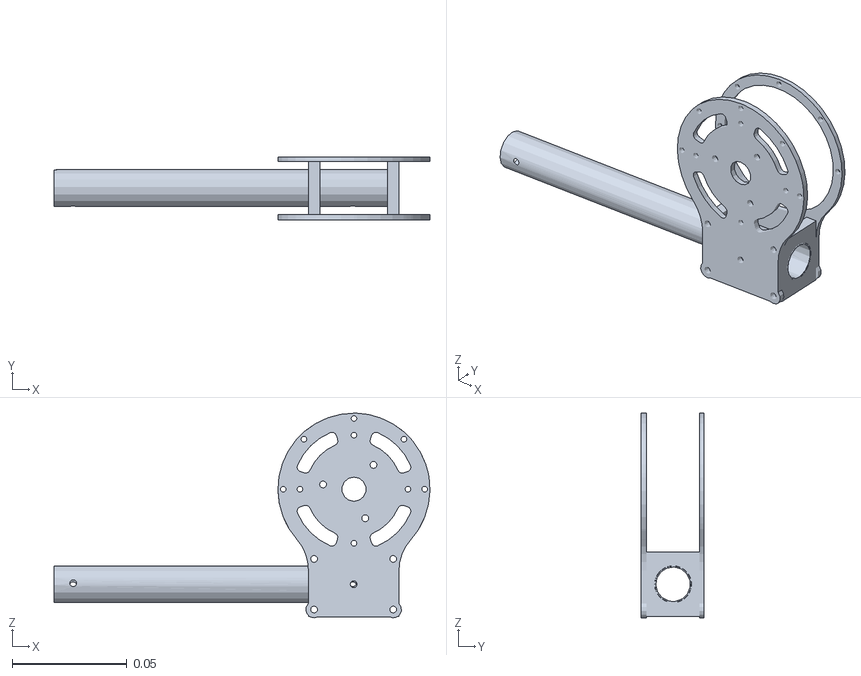
[picture p47: CAD file, 2025-03-02]
4.Development/LocomotionWithNP3O-masteroldx/resources/tinymal/meshes/FR_calf.STL
0.163 x 0.0275 x 0.089
