X-lanni/Tinker/4.Development/tinker/meshes/link_l_ankle.STL

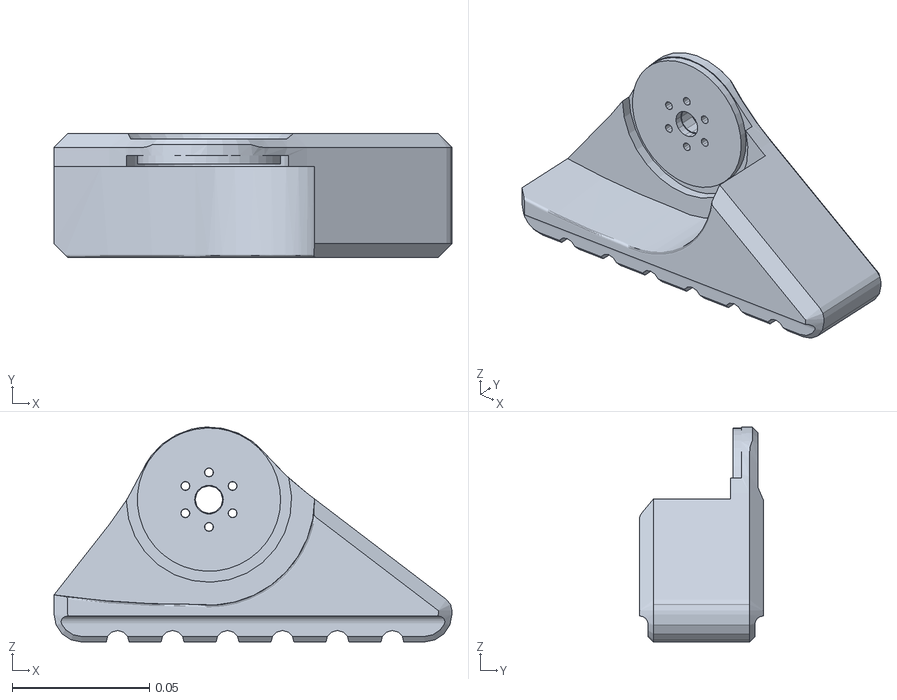
[picture p48: CAD file, 2025-03-02]
4.Development/tinker/meshes/link_l_ankle.STL
0.145 x 0.045 x 0.0782
