X-lanni/Tinker/2.Assemble/Hardware/3d打印件/print-20241204T155423Z-001/print/足端7.STEP

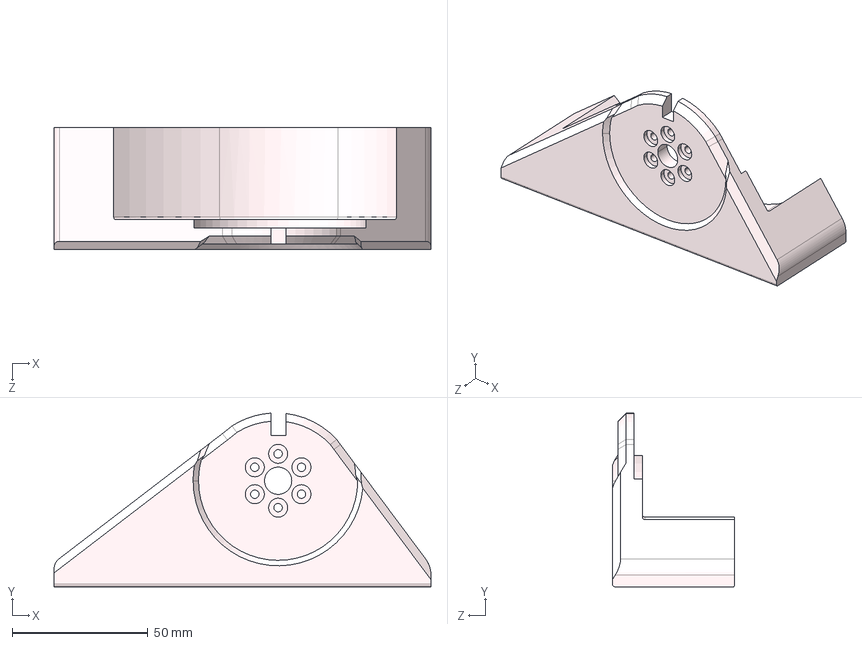
[picture p49: CAD file, 2025-03-02]
2.Assemble/Hardware/3d打印件/print-20241204T155423Z-001/print/足端7.STEP
138.9 x 64.0 x 45.0 mm
