X-lanni/Tinker/2.Assemble/Hardware/碳钎维加工/cut-20241204T155151Z-001/cut/踝关节碳板.STEP

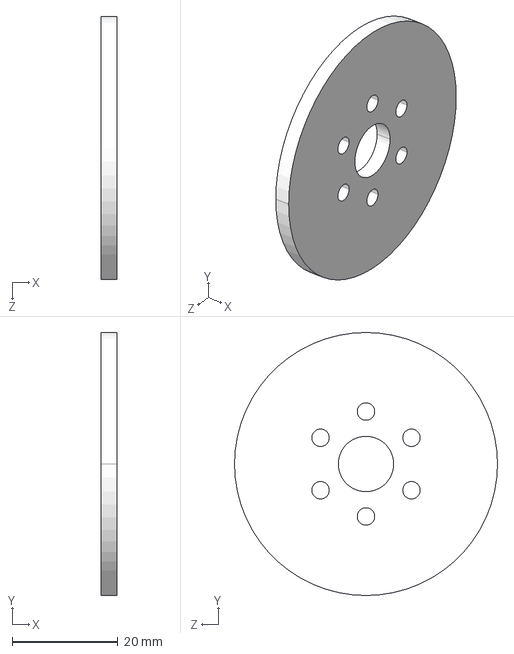
[picture p50: CAD file, 2025-03-02]
2.Assemble/Hardware/碳钎维加工/cut-20241204T155151Z-001/cut/踝关节碳板.STEP
3.00 x 49.8 x 49.8 mm
