X-lanni/Tinker/4.Development/LocomotionWithNP3O-masteroldx/resources/tinymal/meshes/FL_hip.STL

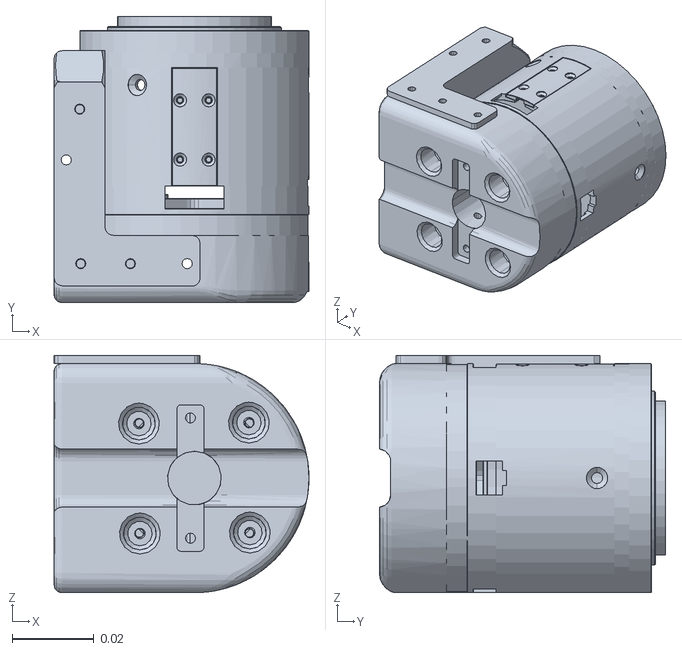
[picture p51: CAD file, 2025-03-02]
4.Development/LocomotionWithNP3O-masteroldx/resources/tinymal/meshes/FL_hip.STL
0.0623 x 0.0699 x 0.058
