X-lanni/Tinker/4.Development/tinker/meshes/link_l_roll.STL

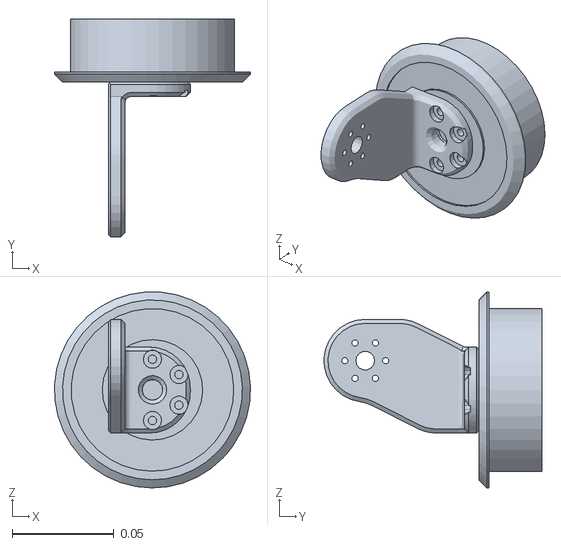
[picture p52: CAD file, 2025-03-02]
4.Development/tinker/meshes/link_l_roll.STL
0.0961 x 0.107 x 0.0961
