X-lanni/Tinker/2.Assemble/Hardware/3d打印件/print-20241204T155423Z-001/print/前盖支持.STEP

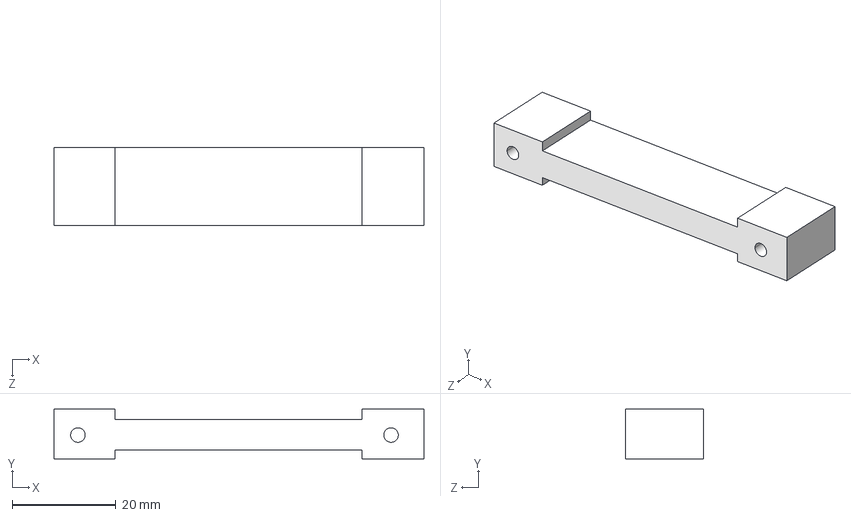
[picture p53: CAD file, 2025-03-02]
2.Assemble/Hardware/3d打印件/print-20241204T155423Z-001/print/前盖支持.STEP
71.3 x 9.60 x 15.0 mm
