X-lanni/Tinker/2.Assemble/Hardware/碳钎维加工/cut-20241204T155151Z-001/cut/大腿侧展 2个.STEP

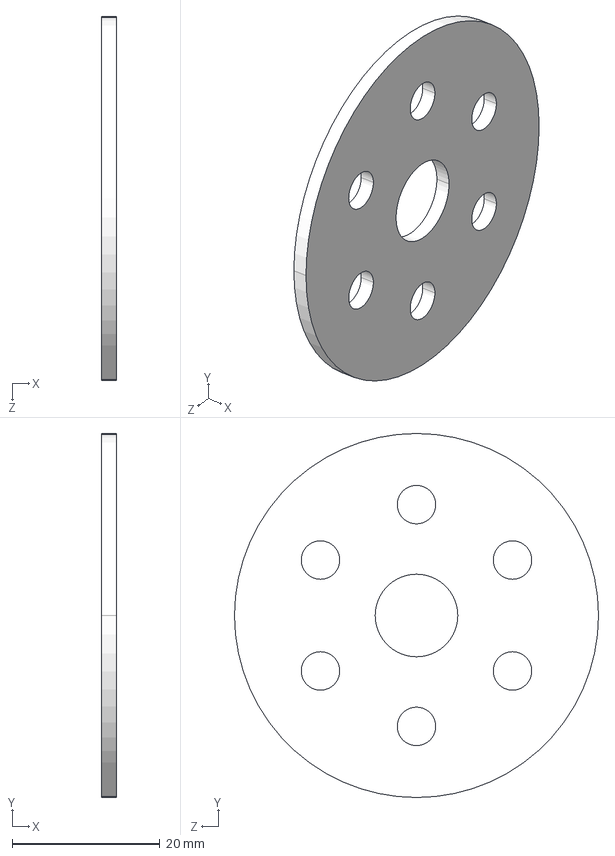
[picture p54: CAD file, 2025-03-02]
2.Assemble/Hardware/碳钎维加工/cut-20241204T155151Z-001/cut/大腿侧展 2个.STEP
2.00 x 49.2 x 49.2 mm
