X-lanni/Tinker/4.Development/LocomotionWithNP3O-masteroldx/resources/tinymal/meshes/RL_thigh.STL

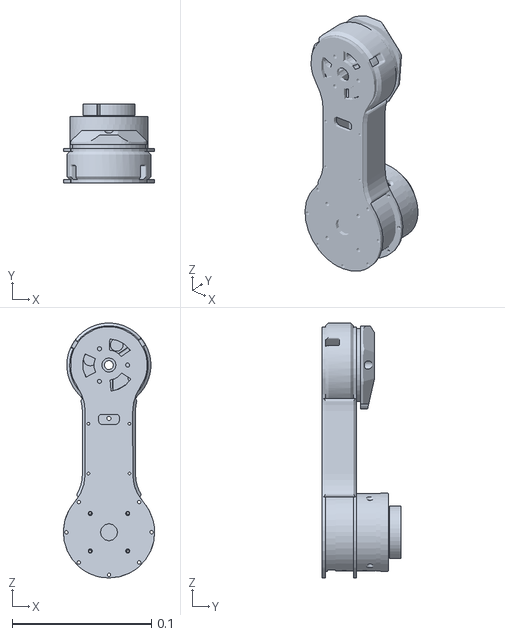
[picture p55: CAD file, 2025-03-02]
4.Development/LocomotionWithNP3O-masteroldx/resources/tinymal/meshes/RL_thigh.STL
0.0656 x 0.0565 x 0.183
