X-lanni/Tinker/2.Assemble/Hardware/3d打印件/print-20241204T155423Z-001/print/足端3外侧.STEP

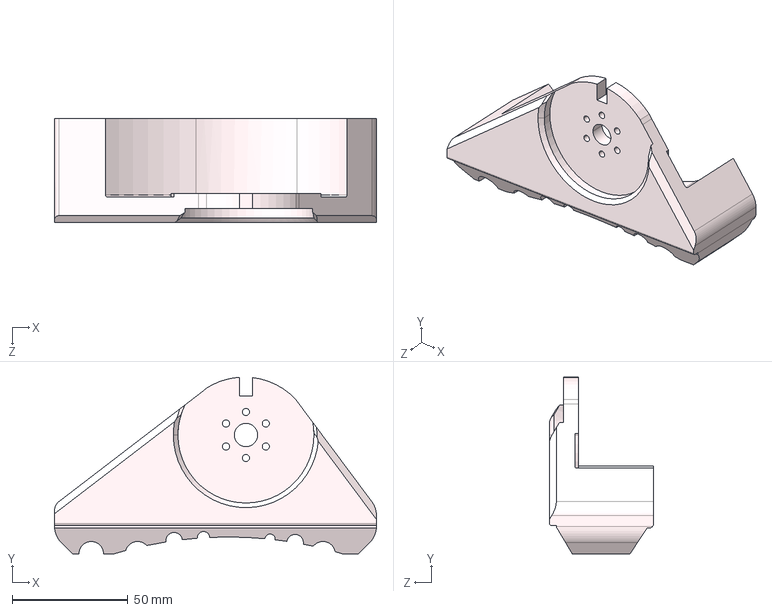
[picture p56: CAD file, 2025-03-02]
2.Assemble/Hardware/3d打印件/print-20241204T155423Z-001/print/足端3外侧.STEP
138.9 x 76.2 x 45.0 mm
