X-lanni/Tinker/2.Assemble/Hardware/碳钎维加工/cut-20241204T155151Z-001/cut/主控支撑.STEP

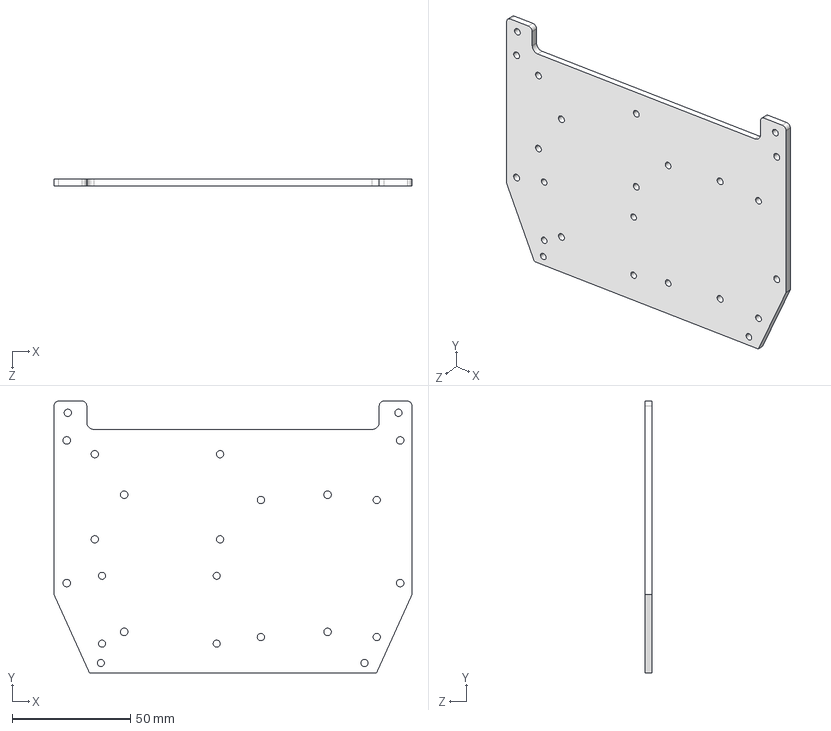
[picture p57: CAD file, 2025-03-02]
2.Assemble/Hardware/碳钎维加工/cut-20241204T155151Z-001/cut/主控支撑.STEP
151.4 x 115.0 x 3.00 mm
