X-lanni/Tinker/2.Assemble/Hardware/3d打印件/print-20241204T155423Z-001/print/路由器支撑.STEP

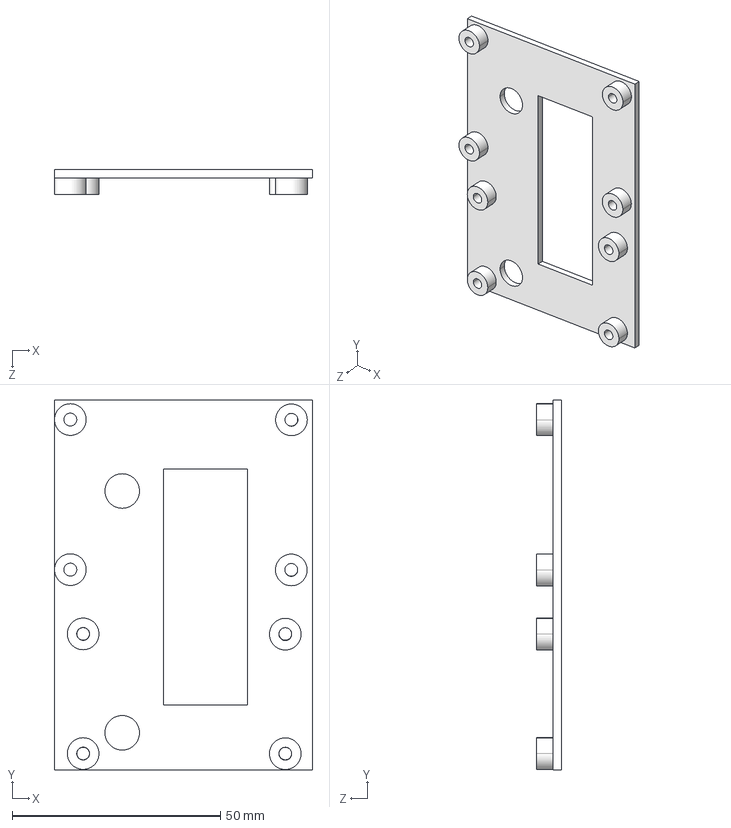
[picture p58: CAD file, 2025-03-02]
2.Assemble/Hardware/3d打印件/print-20241204T155423Z-001/print/路由器支撑.STEP
61.9 x 88.8 x 6.00 mm
