X-lanni/Tinker/4.Development/tinker/meshes/link_r_ankle.STL

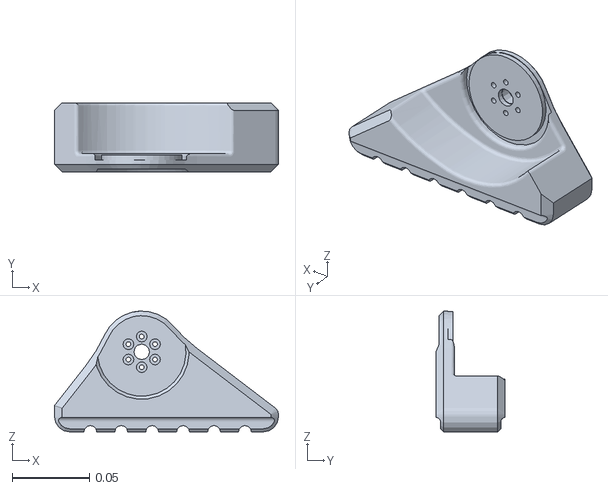
[picture p60: CAD file, 2025-03-02]
4.Development/tinker/meshes/link_r_ankle.STL
0.145 x 0.0449 x 0.0782
