X-lanni/Tinker/2.Assemble/Hardware/3d打印件/print-20241204T155423Z-001/print/电池支架.STEP

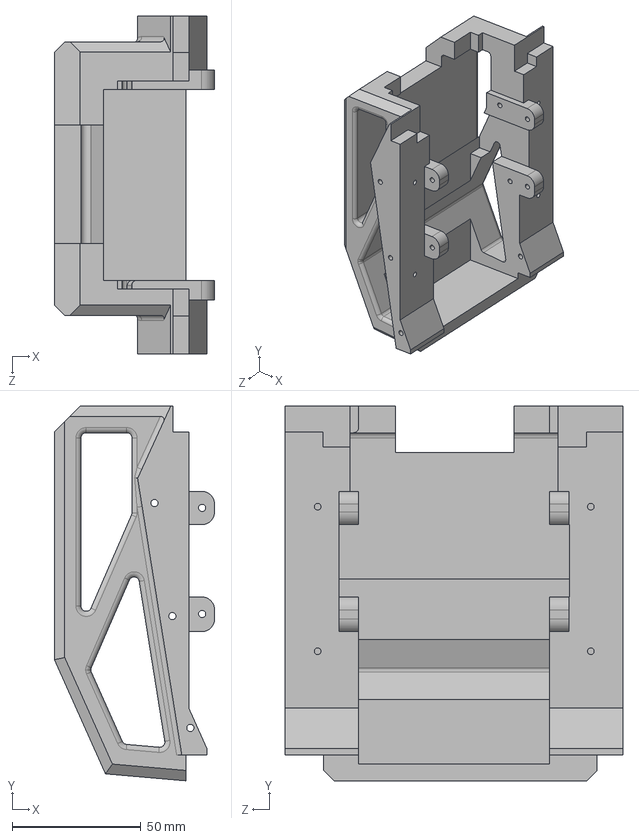
[picture p61: CAD file, 2025-03-02]
2.Assemble/Hardware/3d打印件/print-20241204T155423Z-001/print/电池支架.STEP
62.1 x 145.2 x 131.0 mm
