X-lanni/Tinker/2.Assemble/Hardware/3d打印件/print-20241204T155423Z-001/print/舵机底座.STEP

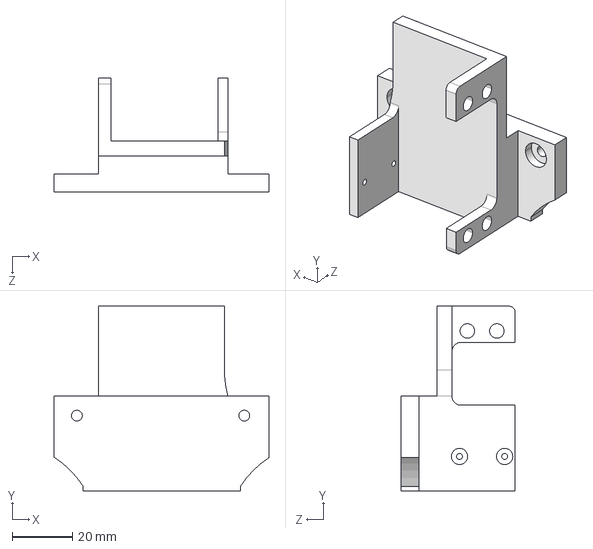
[picture p63: CAD file, 2025-03-02]
2.Assemble/Hardware/3d打印件/print-20241204T155423Z-001/print/舵机底座.STEP
71.4 x 61.4 x 38.0 mm
