X-lanni/Tinker/2.Assemble/Hardware/3d打印件/print-20241204T155423Z-001/print/小腿结构DC.STEP

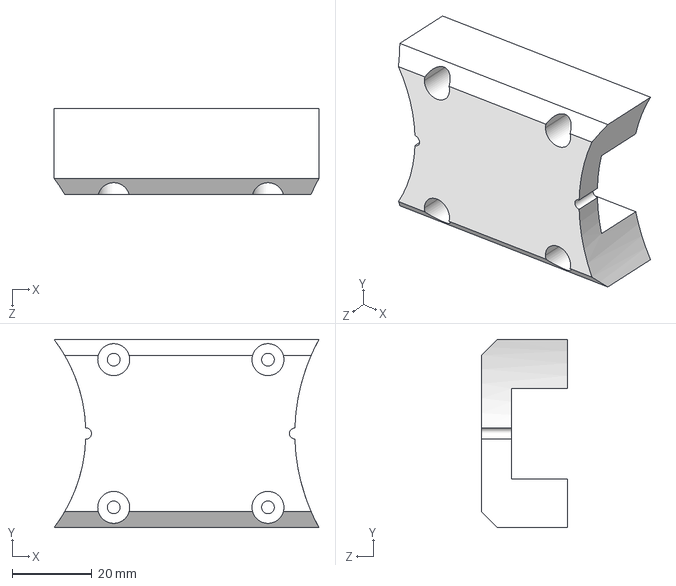
[picture p64: CAD file, 2025-03-02]
2.Assemble/Hardware/3d打印件/print-20241204T155423Z-001/print/小腿结构DC.STEP
66.5 x 47.3 x 21.5 mm
