X-lanni/Tinker/4.Development/LocomotionWithNP3O-masteroldx/resources/tinymal/meshes/FR_foot.STL

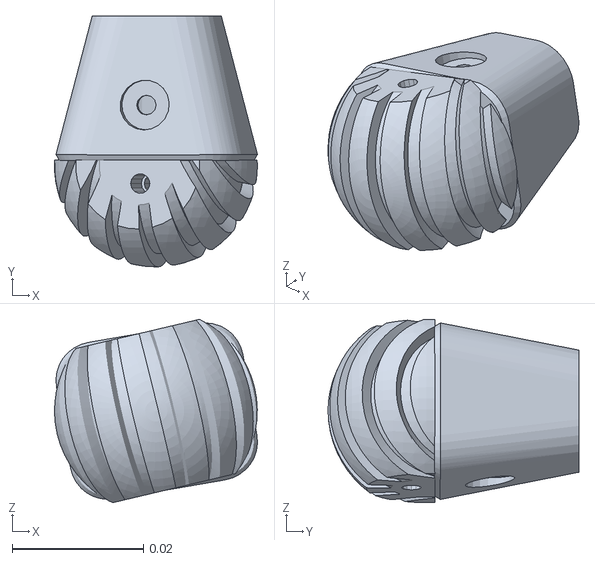
[picture p66: CAD file, 2025-03-02]
4.Development/LocomotionWithNP3O-masteroldx/resources/tinymal/meshes/FR_foot.STL
0.0309 x 0.0382 x 0.0279
