X-lanni/Tinker/2.Assemble/Hardware/3d打印件/print-20241204T155423Z-001/print/脖子支撑.STEP

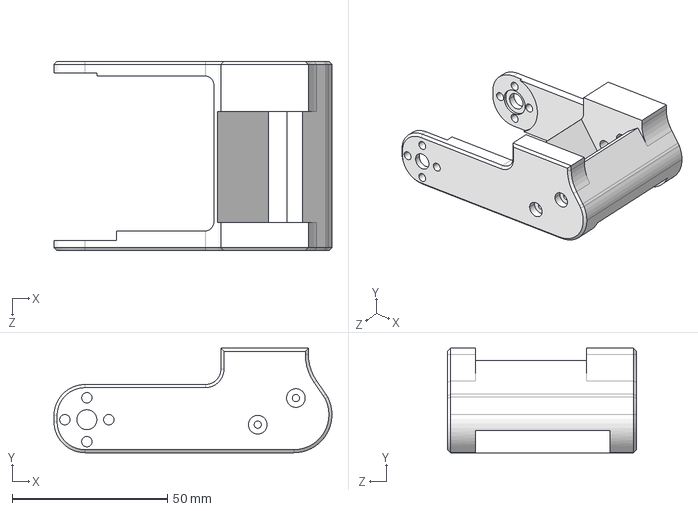
[picture p67: CAD file, 2025-03-02]
2.Assemble/Hardware/3d打印件/print-20241204T155423Z-001/print/脖子支撑.STEP
89.6 x 33.7 x 61.0 mm
