X-lanni/Tinker/2.Assemble/Hardware/3d打印件/print-20241204T155423Z-001/print/jetson支撑.STEP

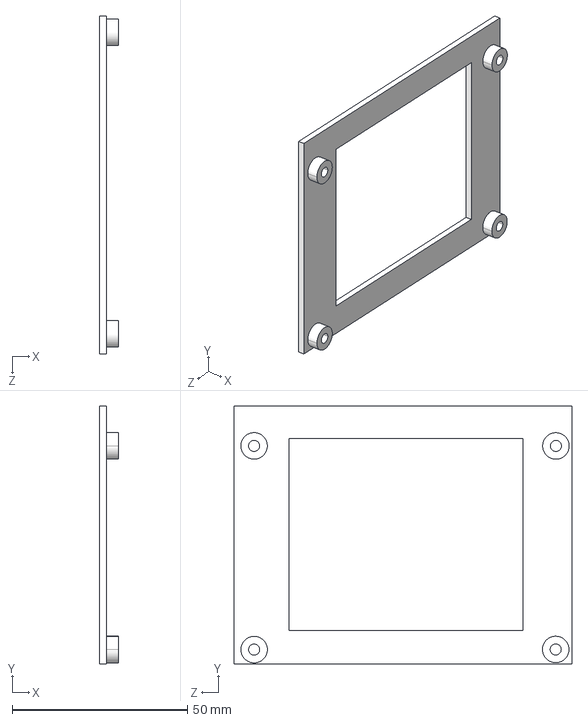
[picture p68: CAD file, 2025-03-02]
2.Assemble/Hardware/3d打印件/print-20241204T155423Z-001/print/jetson支撑.STEP
5.50 x 73.5 x 96.3 mm
