X-lanni/Tinker/2.Assemble/Hardware/3d打印件/print-20241204T155423Z-001/print/电池固定 2个.STEP

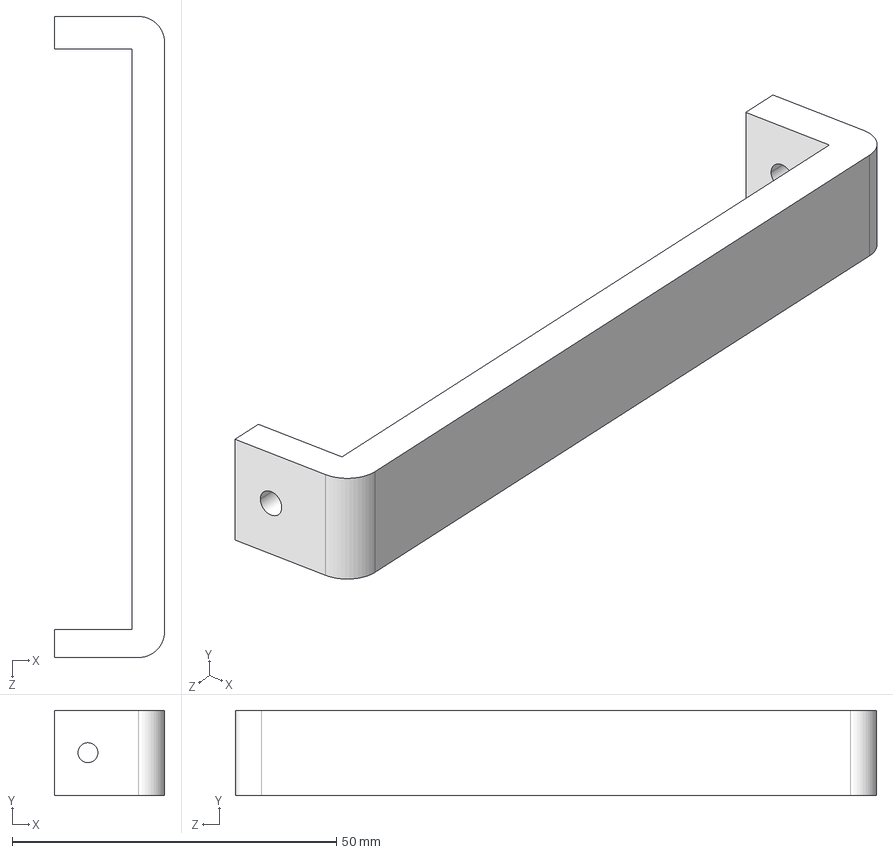
[picture p69: CAD file, 2025-03-02]
2.Assemble/Hardware/3d打印件/print-20241204T155423Z-001/print/电池固定 2个.STEP
17.0 x 13.2 x 98.9 mm
