X-lanni/Tinker/4.Development/LocomotionWithNP3O-masteroldx/resources/tinymal/meshes/RR_thigh.STL

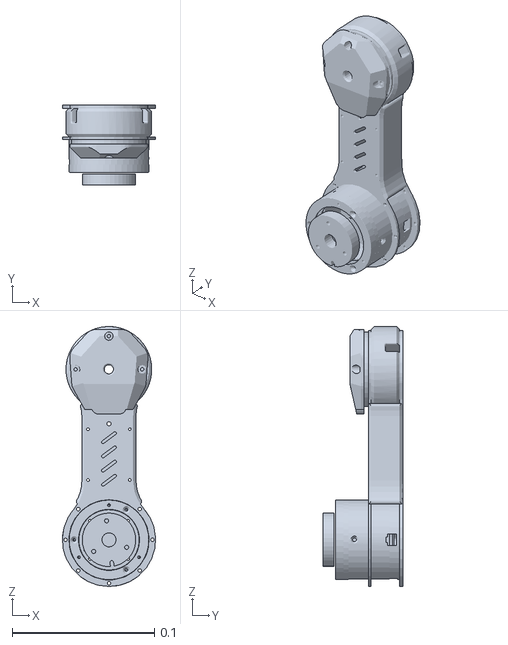
[picture p70: CAD file, 2025-03-02]
4.Development/LocomotionWithNP3O-masteroldx/resources/tinymal/meshes/RR_thigh.STL
0.0656 x 0.0565 x 0.183
