X-lanni/Tinker/2.Assemble/Hardware/3d打印件/print-20241204T155423Z-001/print/大腿结构DC.STEP

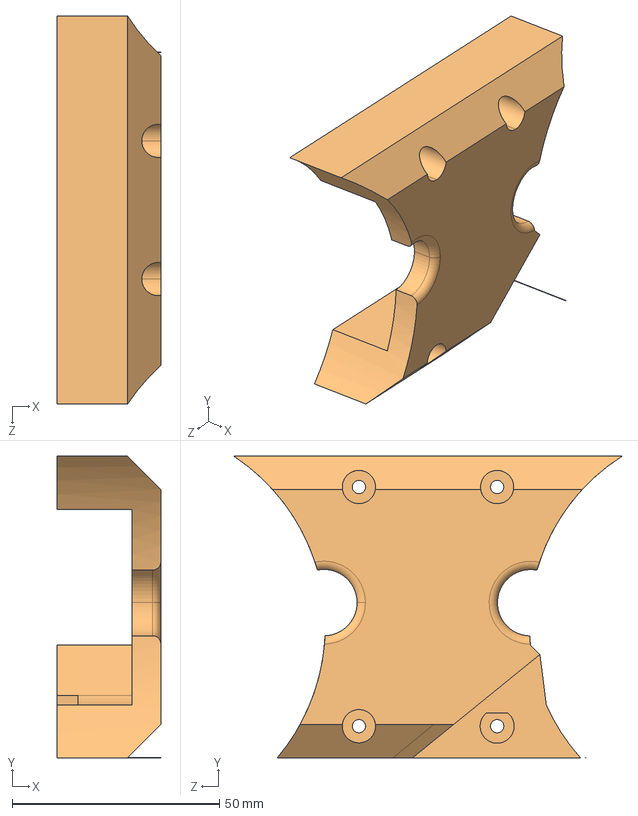
[picture p71: CAD file, 2025-03-02]
2.Assemble/Hardware/3d打印件/print-20241204T155423Z-001/print/大腿结构DC.STEP
25.0 x 72.7 x 93.6 mm
