X-lanni/Tinker/2.Assemble/Hardware/3d打印件/print-20241204T155423Z-001/print/后盖保护壳.STEP

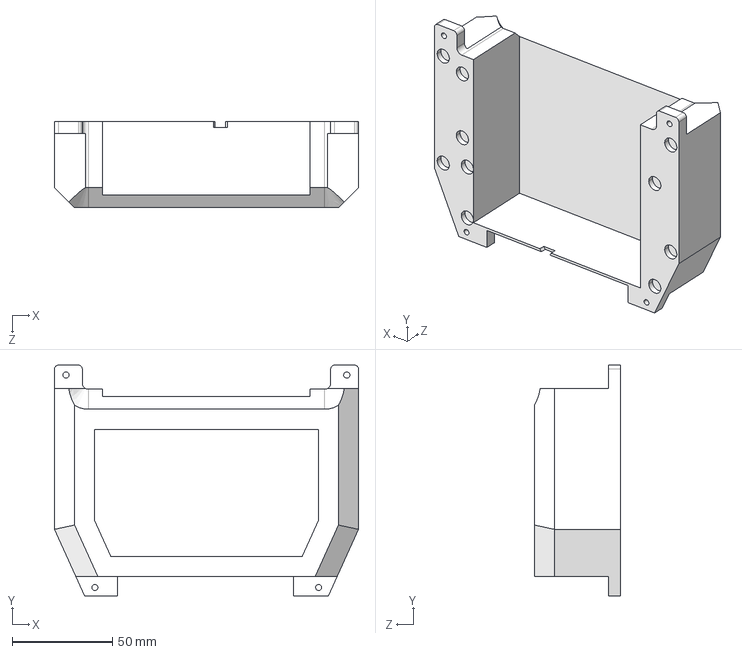
[picture p72: CAD file, 2025-03-02]
2.Assemble/Hardware/3d打印件/print-20241204T155423Z-001/print/后盖保护壳.STEP
151.4 x 115.0 x 43.0 mm
