X-lanni/Tinker/2.Assemble/Hardware/3d打印件/print-20241204T155423Z-001/print/足端6.STEP

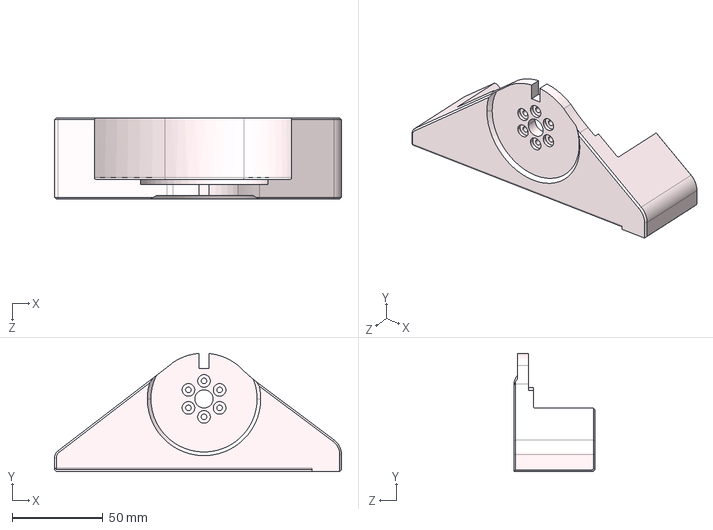
[picture p73: CAD file, 2025-03-02]
2.Assemble/Hardware/3d打印件/print-20241204T155423Z-001/print/足端6.STEP
158.6 x 65.4 x 45.0 mm
