X-lanni/Tinker/2.Assemble/Hardware/3d打印件/print-20241204T155423Z-001/print/底部支撑DC.STEP

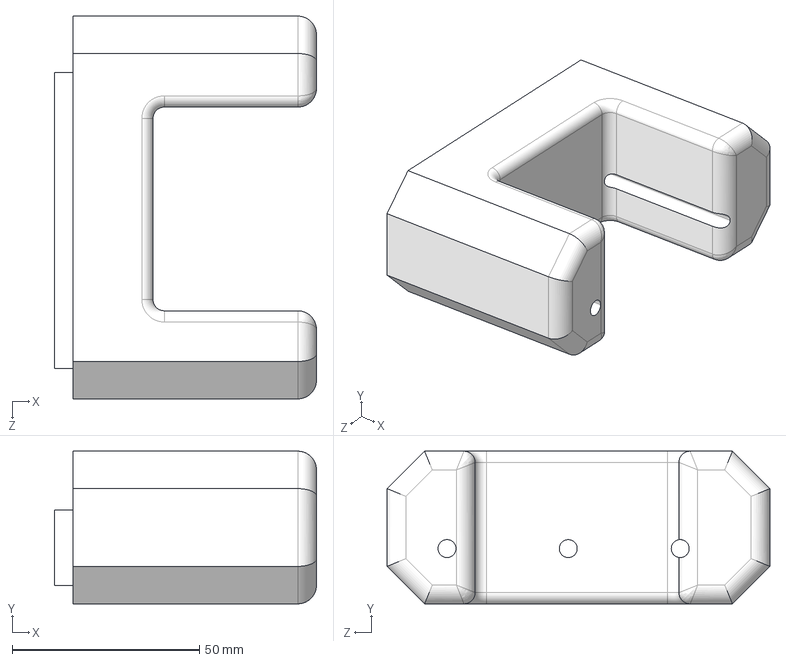
[picture p74: CAD file, 2025-03-02]
2.Assemble/Hardware/3d打印件/print-20241204T155423Z-001/print/底部支撑DC.STEP
70.0 x 40.8 x 102.3 mm
