X-lanni/Tinker/2.Assemble/Hardware/3d打印件/print-20241204T155423Z-001/print/开关固定.STEP

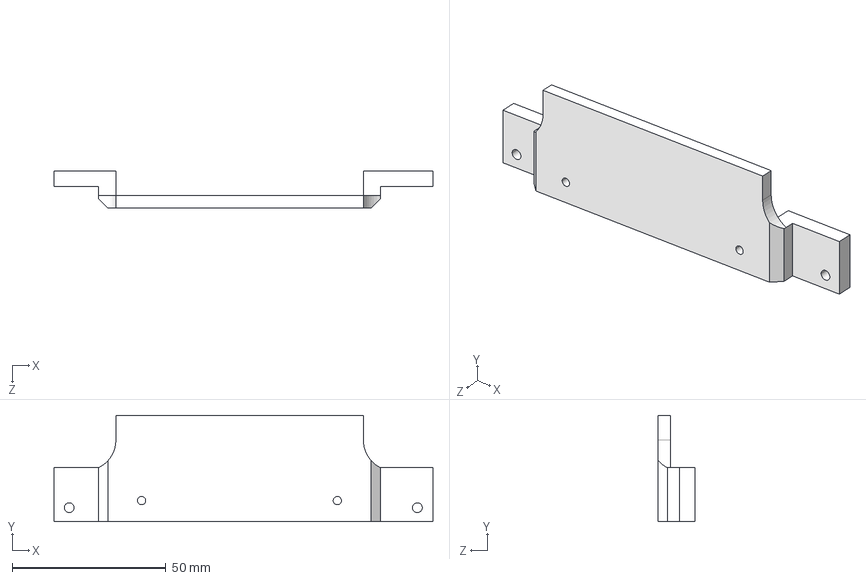
[picture p75: CAD file, 2025-03-02]
2.Assemble/Hardware/3d打印件/print-20241204T155423Z-001/print/开关固定.STEP
123.4 x 34.6 x 12.0 mm
