X-lanni/Tinker/2.Assemble/Hardware/3d打印件/print-20241204T155423Z-001/print/头盖.STEP

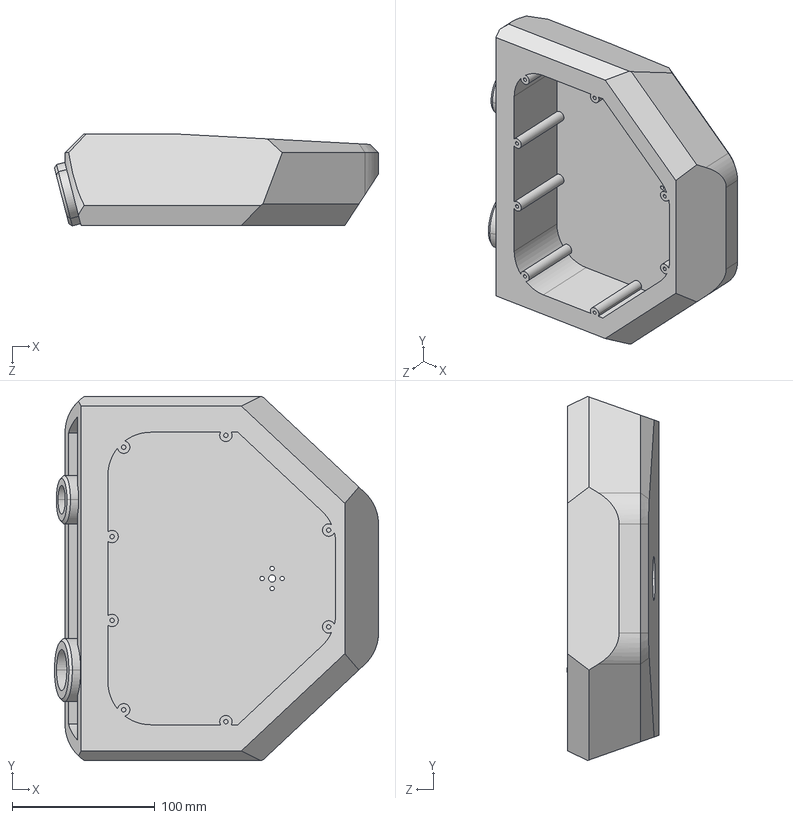
[picture p76: CAD file, 2025-03-02]
2.Assemble/Hardware/3d打印件/print-20241204T155423Z-001/print/头盖.STEP
226.8 x 254.8 x 64.3 mm
