X-lanni/Tinker/(list of files, cad)

Other CAD files:
4.Development/LocomotionWithNP3O-masteroldx/resources/tinker/meshes/link_l_knee.STL
4.Development/LocomotionWithNP3O-masteroldx/resources/tinker/meshes/link_l_yaw.STL
4.Development/tinker/meshes/link_r_roll.STL
4.Development/LocomotionWithNP3O-masteroldx/resources/tinker/meshes/link_r_pitch.STL
4.Development/LocomotionWithNP3O-masteroldx/resources/tinymal/meshes/RL_calf.STL
4.Development/LocomotionWithNP3O-masteroldx/resources/tinker/meshes/link_r_roll.STL
4.Development/LocomotionWithNP3O-masteroldx/resources/tinymal/meshes/FR_thigh.STL
4.Development/LocomotionWithNP3O-masteroldx/resources/tinymal/meshes/RL_foot.STL
4.Development/tinker/meshes/link_r_pitch.STL
2.Assemble/Hardware/碳钎维加工/cut-20241204T155151Z-001/cut/大腿2.STEP
4.Development/LocomotionWithNP3O-masteroldx/resources/tinymal/meshes/FL_calf.STL
4.Development/tinker/meshes/link_l_yaw.STL
4.Development/LocomotionWithNP3O-masteroldx/resources/tinymal/meshes/FL_foot.STL
2.Assemble/Hardware/3d打印件/print-20241204T155423Z-001/print/足端3 DC 粗糙.STEP
4.Development/tinker/meshes/link_l_knee.STL
4.Development/LocomotionWithNP3O-masteroldx/resources/tinymal/meshes/RL_hip.STL
4.Development/LocomotionWithNP3O-masteroldx/resources/tinymal/meshes/FR_hip.STL
4.Development/LocomotionWithNP3O-masteroldx/resources/tinymal/meshes/RR_calf.STL
4.Development/LocomotionWithNP3O-masteroldx/resources/tinymal/meshes/FL_thigh.STL
