X-lanni/Tinker/2.Assemble/TinkerV1_assemblyprocedure.pdf

# Tinker V1

# 装配工艺卡片

# 产品型号及名称：_______________________ 工艺文件名称：_________________________

人形机器人（上海）有限公司 | 装配工艺卡 | 部件号 | | 工位号 | 共 25 页
| | 部件名称 | | | 第 1 页
工序号 | | 工序名称 | 电机标定
序号 | 工作内容 | 工具名称 | 数量 | 图示
1 | 把每个关节位置电机准备好
2 | 完成对所有电机的标定与参数配置
关节位置 | CAN ID | 电机型号 | 固件
yaw 偏转 | 1 | 6006 | V2552
rol 偏转 | 2 | 8006 | V3317
大腿 | 3 | 8006 | V3317
小腿 | 4 | 8006 | V3317
踝关节 | 5 | 6006 | V2552

人形机器人（上海）有限公司 | 装配工艺卡 | 部件号 | | 工位号 | 共 25 页
| | 部件名称 | 整体示意图 | | 第 2 页
工序号 | | 工序名称 | 电机序号位置
序号 | 工作内容 | 工具名称 | 数量 | 图示
1 | 左右腿电机 ID 顺序一致，如右图所示
2 | 组装中首先把各电机 CAN 和供电线接好方便组 装后的焊接工作

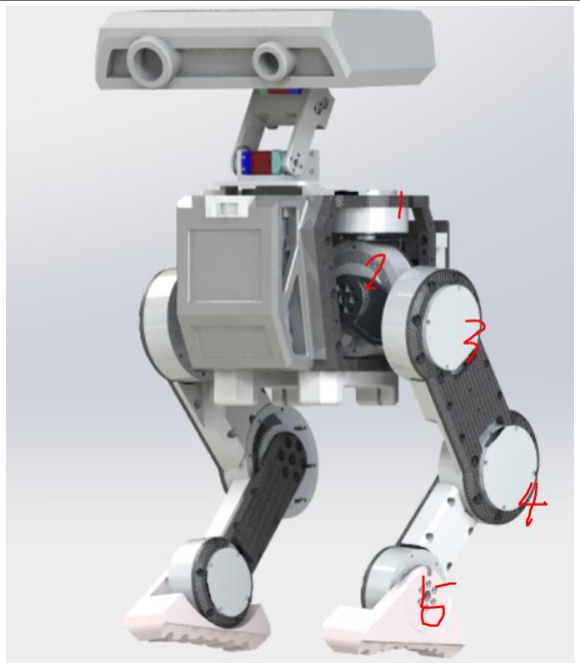
[picture p95: figure]

人形机器人（上海）有限公司 | 装配工艺卡 | 部件号 | | 工位号 | 共 25 页
| | 部件名称 | 机体底板 | | 第 3 页
工序号 | | 工序名称 | 中框
序号 | 工作内容 | 工具名称 | 数量 | 图示
1 | 注意机体底板后面缺口处为电池位置

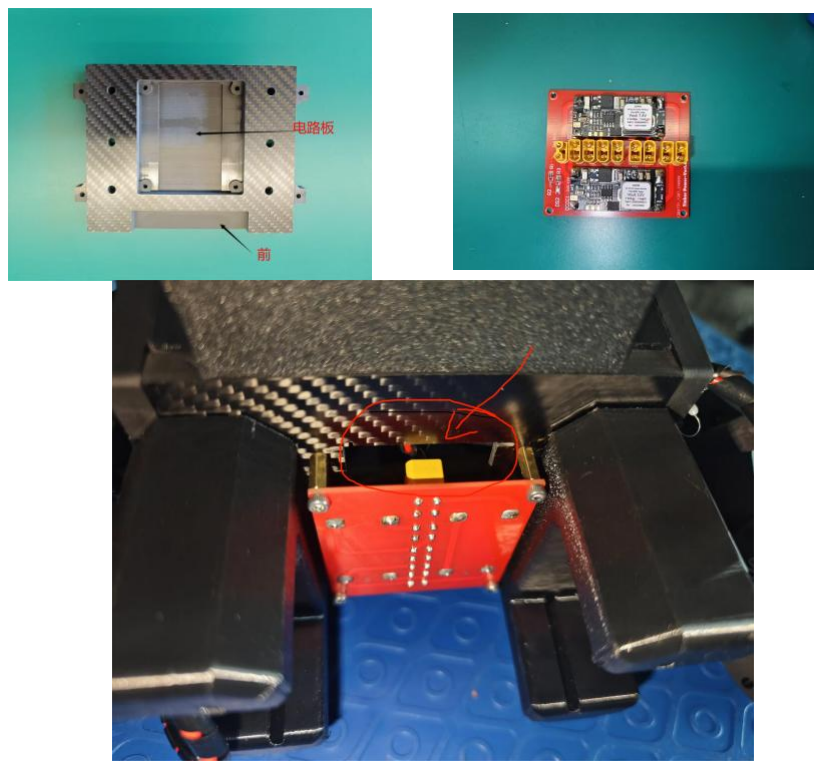
[picture p96: figure]

2 | 缺口方向与机器人前向相同
3 | 把电源板固定在底板中间位置下放
4 | 使用六角螺柱连接，两端用 M3×6 螺丝
5 | 底板中间切出矩形口，以防电路板上元器件 与机体干涉
6 | 电源板以最后线路分布确定方向

人形机器人（上海）有限公司 | 装配工艺卡 | 部件号 | | 工位号 | 共 25 页
| | 部件名称 | 机体底板 | | 第 4 页
工序号 | | 工序名称 | 中框
序号 | 工作内容 | 工具名称 | 数量 | 图示
1 | 把支撑架安装到机体底板上
2 | 由于支撑架安装处边缘是直角与底板圆角干 涉

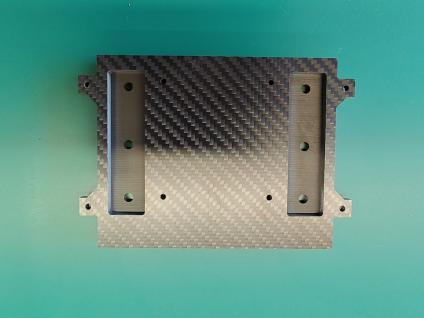
[picture p97: figure]

3 | 给支撑架安装处倒角
4 | 安装处涂上胶水安装到底板上

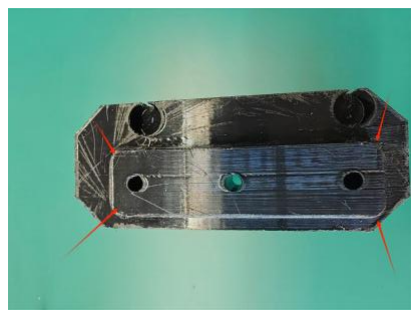
[picture p98: figure]
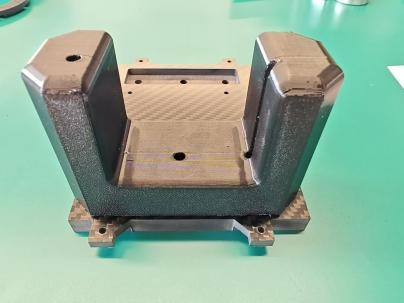
[picture p99: figure]

人形机器人（上海）有限公司 | 装配工艺卡 | 部件号 | | 工位号 | 共 25 页
| | 部件名称 | | | 第 5 页
工序号 | | 工序名称 | 螺丝紧固注意
序号 | 工作内容 | 工具名称 | 数量 | 图示
1 | 所有螺丝要涂低强度螺纹胶
2 | 螺纹胶涂螺丝的前三牙
3 | 如要拆卸涂胶螺丝用热风枪加热

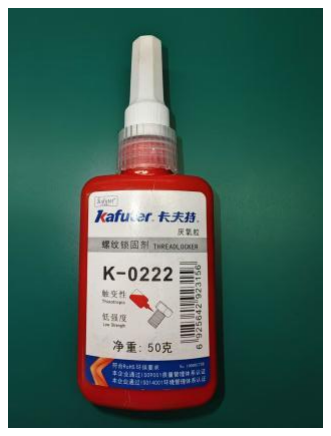
[picture p100: figure]
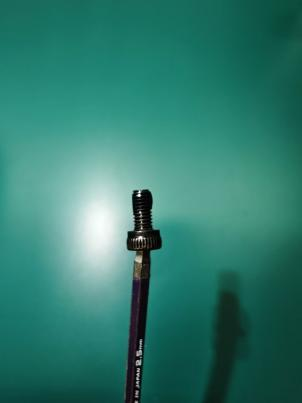
[picture p101: figure]

人形机器人（上海）有限公司 | 装配工艺卡 | 部件号 | | 工位号 | 共 25 页
| | 部件名称 | 小腿 | | 第 6 页
工序号 | | 工序名称 | 小腿支撑板处理
序号 | 工作内容 | 工具名称 | 数量 | 图示
1 | 注意小腿结构件走线槽容易压坏线缆
2 | 结构件材质是碳钎维板会导电
3 | 在线槽直角边缘倒角并贴上绝缘胶带

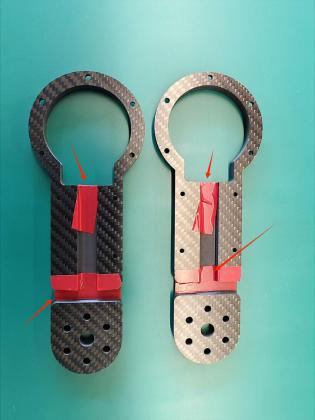
[picture p102: figure]
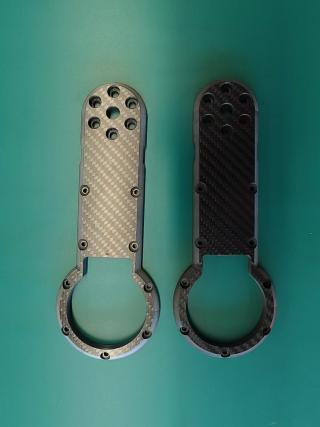
[picture p103: figure]

人形机器人（上海）有限公司 | 装配工艺卡 | 部件号 | | 工位号 | 共 25 页
| | 部件名称 | 小腿 | | 第 7 页
工序号 | | 工序名称 | 小腿舵机安装
序号 | 工作内容 | 工具名称 | 数量 | 图示
1 | 舵机安装前先插上线速，方便装完后焊接

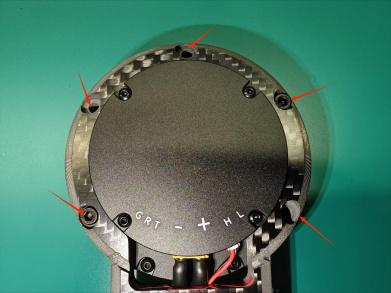
[picture p104: figure]
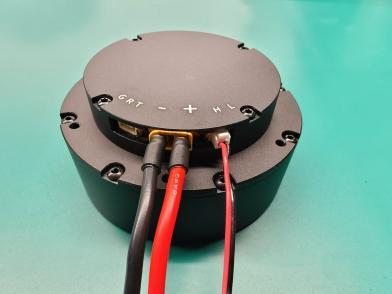
[picture p105: figure]

2 | 线速对应接口插上
3 | 安装过程中注意线速在走线槽里，以防螺丝 上紧压坏
4 | 用 5 颗 M3×6 螺丝，注意涂螺纹胶
5 | 先对角螺丝预紧，所有螺丝都上了之后对角 拧紧

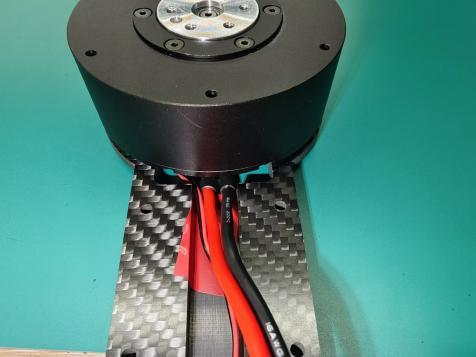
[picture p106: figure]

人形机器人（上海）有限公司 | 装配工艺卡 | 部件号 | | 工位号 | 共 25 页
| | 部件名称 | 小腿 | | 第 8 页
工序号 | | 工序名称 | 小腿安装
序号 | 工作内容 | 工具名称 | 数量 | 图示
1 | 线速保护盖安装到小腿结构件上

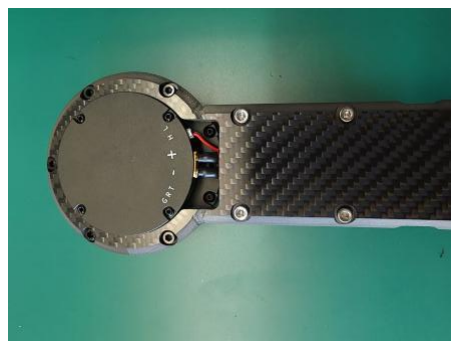
[picture p107: figure]
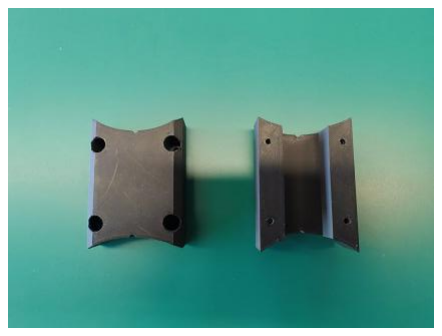
[picture p108: figure]

2 | 安装过程注意不要压到线速
3 | 用 M3×14 螺丝和 M3 螺母对接上紧

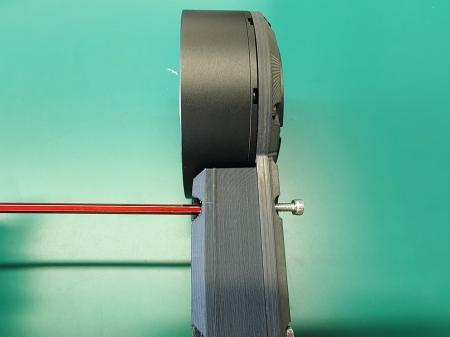
[picture p109: figure]

人形机器人（上海）有限公司 | 装配工艺卡 | 部件号 | | 工位号 | 共 25 页
| | 部件名称 | 小腿 | | 第 9 页
工序号 | | 工序名称 | 小腿安装
序号 | 工作内容 | 工具名称 | 数量 | 图示
1 | 线速出来提前固定线速位置

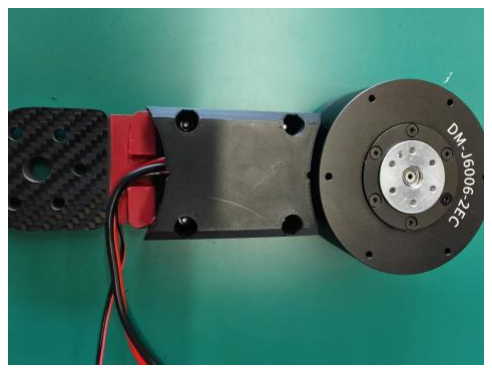
[picture p110: figure]

2 | 左右腿线速方向相反
3 | 用热熔胶固定好线速位置，后续大腿小腿连 接方便

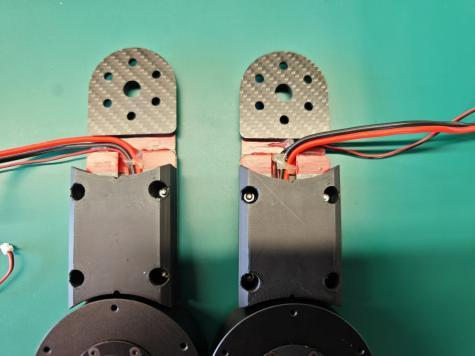
[picture p111: figure]

人形机器人（上海）有限公司 | 装配工艺卡 | 部件号 | | 工位号 | 共 25 页
| | 部件名称 | 大腿 | | 第 10 页
工序号 | | 工序名称 | 大腿舵机安装
序号 | 工作内容 | 工具名称 | 数量 | 图示
1 | 大腿线槽边缘与小腿一样倒角贴绝缘胶带

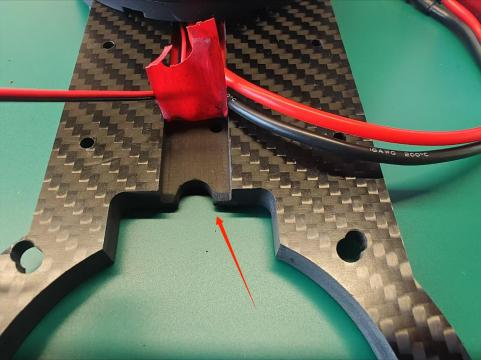
[picture p112: figure]

2 | 安装前插接好线速
3 | 结构板圆的大弧度方向朝上，面向自己
4 | 3 号舵机装左边，4 号舵机装右边
5 | 注意不要压住线速
6 | 用 14 颗 M4×10 螺丝

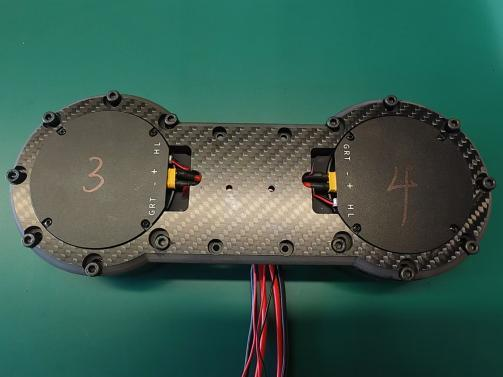
[picture p113: figure]

7 | 注意涂螺纹胶

人形机器人（上海）有限公司 | 装配工艺卡 | 部件号 | | 工位号 | 共 25 页
| | 部件名称 | 腿部连接 | | 第 11 页
工序号 | | 工序名称 | 大腿小腿连接
序号 | 工作内容 | 工具名称 | 数量 | 图示
1 | 把小腿结构件安装到大腿 4 号舵机背面

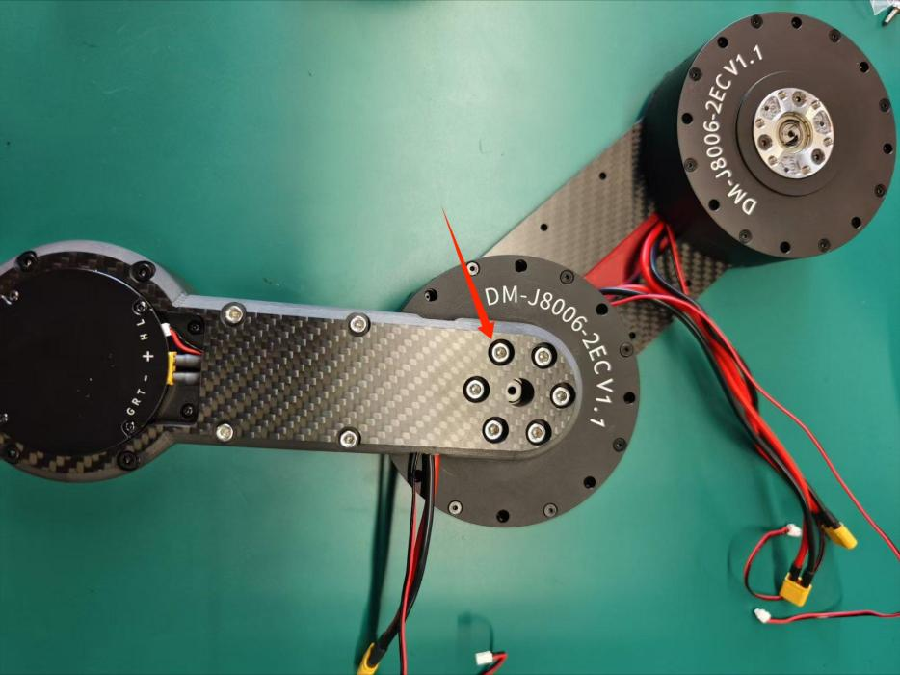
[picture p114: figure]

2 | 用 M3×8 螺丝固定
3 | 注意要涂螺纹胶

人形机器人（上海）有限公司 | 装配工艺卡 | 部件号 | | 工位号 | 共 25 页
| | 部件名称 | 腿部连接 | | 第 12 页
工序号 | | 工序名称 | 大腿安装
序号 | 工作内容 | 工具名称 | 数量 | 图示
1 | 大腿盖线板先用胶布带上，接线完成后螺丝 锁紧

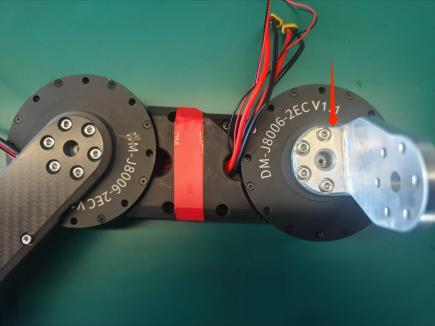
[picture p115: figure]

2 | 把连接件安装到 3 号舵机上
3 | 用 M4×10 螺丝锁紧
3 | 注意涂螺纹胶

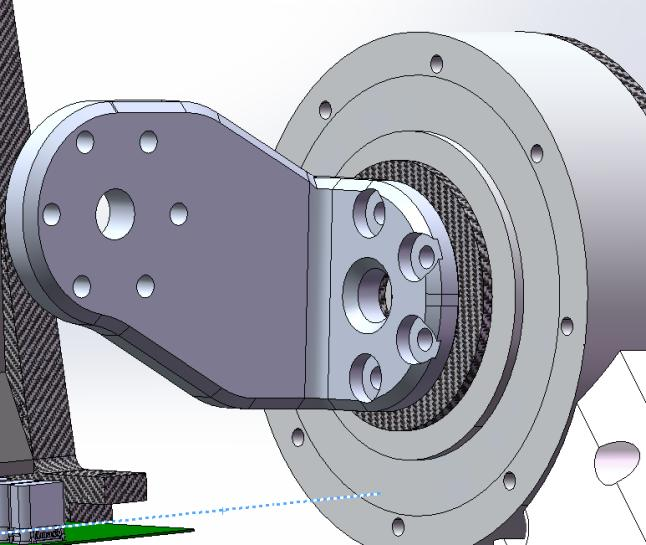
[picture p116: figure]

人形机器人（上海）有限公司 | 装配工艺卡 | 部件号 | | 工位号 | 共 25 页
| | 部件名称 | 中框 | | 第 13 页
工序号 | | 工序名称 | 中框躯体
序号 | 工作内容 | 工具名称 | 数量 | 图示
1 | 中框上部结构件与 1 号舵机连接

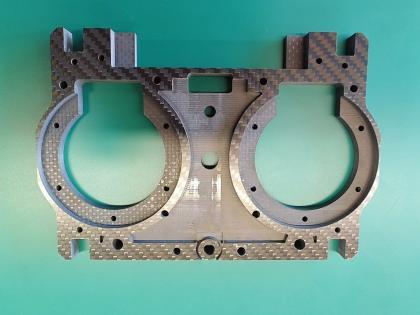
[picture p117: figure]

2 | 注意舵机线速插口与出线口对应
3 | 注意不要压伤线速
4 | 用 10 颗 M3×6 的螺丝上紧
6 | 注意涂螺纹胶

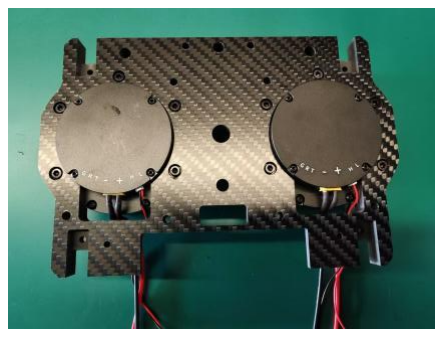
[picture p118: figure]

人形机器人（上海）有限公司 | 装配工艺卡 | 部件号 | | 工位号 | 共 25 页
| | 部件名称 | 中框 | | 第 14 页
工序号 | | 工序名称 | 中框电机安装
序号 | 工作内容 | 工具名称 | 数量 | 图示
1 | 把铝合金结构件安装到 1 号舵机背部
2 | 用 12 颗 M3×6 螺丝固定
3 | 注意涂螺纹胶

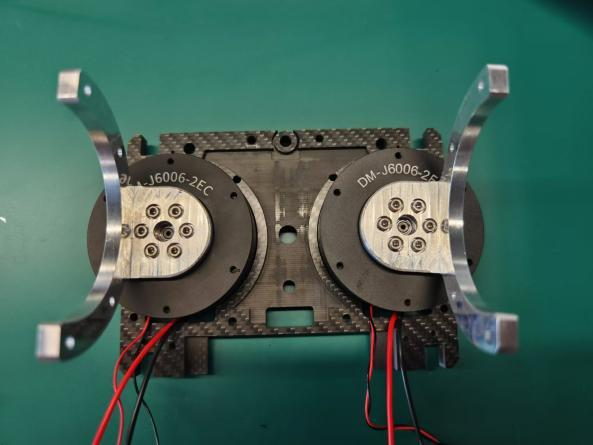
[picture p119: figure]

人形机器人（上海）有限公司 | 装配工艺卡 | 部件号 | | 工位号 | 共 25 页
| | 部件名称 | 中框 | | 第 15 页
工序号 | | 工序名称 | 周转电机安装
序号 | 工作内容 | 工具名称 | 数量 | 图示
1 | 顶部线速出口方向是机器人前向

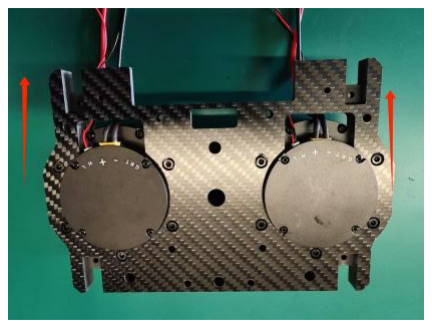
[picture p120: figure]

2 | 把两个二号舵机安装在支撑架上
3 | 注意两舵机接口相对
4 | 2 号舵机机体方向朝前，支撑架朝后
5 | 用 10 颗 M4×8 螺丝固定
6 | 注意涂螺纹胶

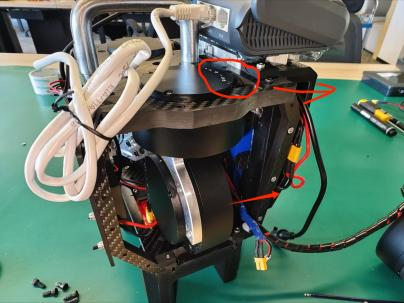
[picture p121: figure]
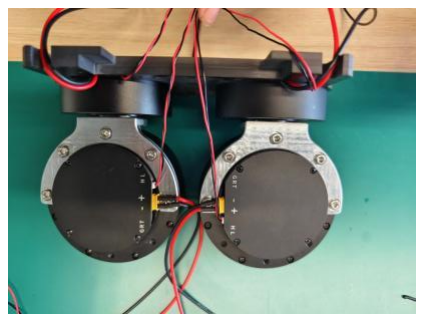
[picture p122: figure]

人形机器人（上海）有限公司 | 装配工艺卡 | 部件号 | | 工位号 | 共 25 页
| | 部件名称 | 腿部连接 | | 第 16 页
工序号 | | 工序名称 | 腿部机体连接
序号 | 工作内容 | 工具名称 | 数量 | 图示
1 | 安装脚，注意长的一边朝前
2 | 注意左右腿方向，大腿大弧度角度方向朝前

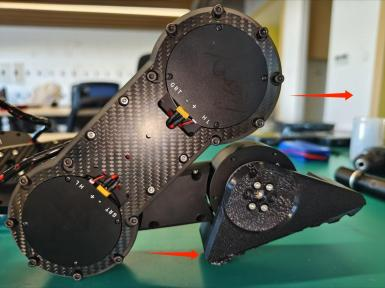
[picture p123: figure]
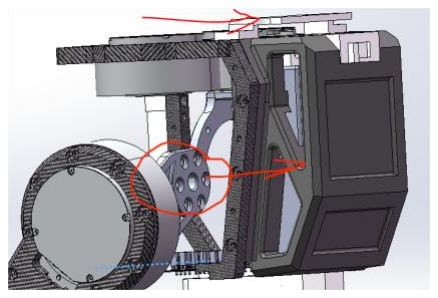
[picture p124: figure]

3 | 腿部连接件与中框舵机连接
4 | 注意连接件安装方向朝前
6 | 用 12 颗 M4×10 螺丝固定
| 注意要涂螺纹胶

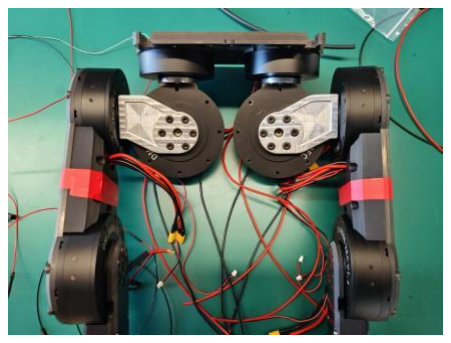
[picture p125: figure]

人形机器人（上海）有限公司 | 装配工艺卡 | 部件号 | | 工位号 | 共 25 页
| | 部件名称 | 中框 | | 第 17 页
工序号 | | 工序名称 | 中框支撑架安装
序号 | 工作内容 | 工具名称 | 数量 | 图示
1 | 支撑架安装在中框四角

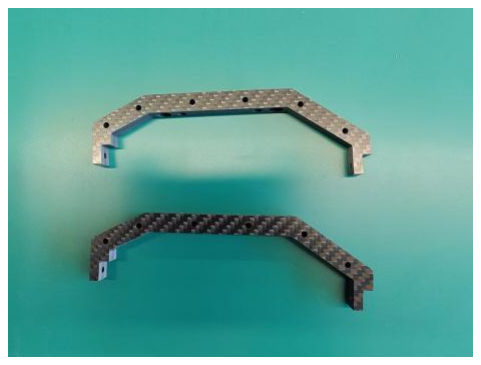
[picture p126: figure]

2 | 用 M3 螺丝螺母固定

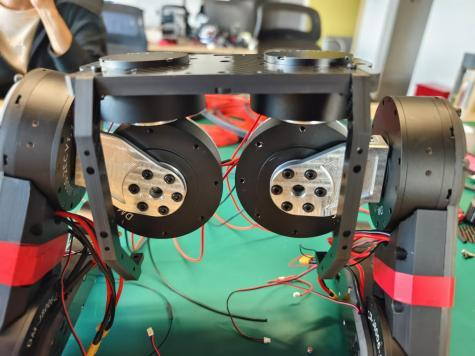
[picture p127: figure]

人形机器人（上海）有限公司 | 装配工艺卡 | 部件号 | | 工位号 | 共 25 页
| | 部件名称 | 中框 | | 第 18 页
工序号 | | 工序名称 | 底板上机准备
序号 | 工作内容 | 工具名称 | 数量 | 图示
1 | 第三页安装完后，上机安装注意底板前向的 凹槽
2 | 凹槽是安装电池的

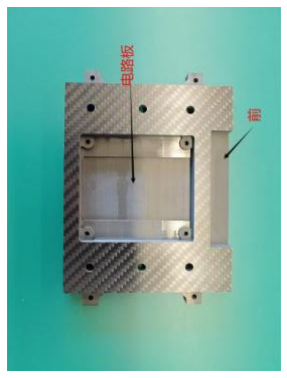
[picture p128: figure]
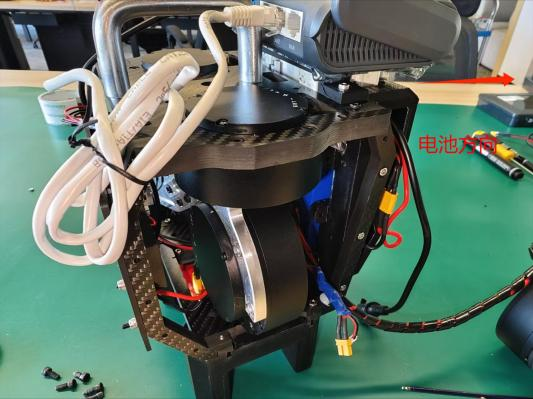
[picture p129: figure]

3 | 电池安装在机器人前面，所以凹槽方向朝前

人形机器人（上海）有限公司 | 装配工艺卡 | 部件号 | | 工位号 | 共 25 页
| | 部件名称 | 中框 | | 第 19 页
工序号 | | 工序名称 | 底部控制板上机
序号 | 工作内容 | 工具名称 | 数量 | 图示
1 | 把第三页提前安装好的底部安装到第十七页 四个支撑架上

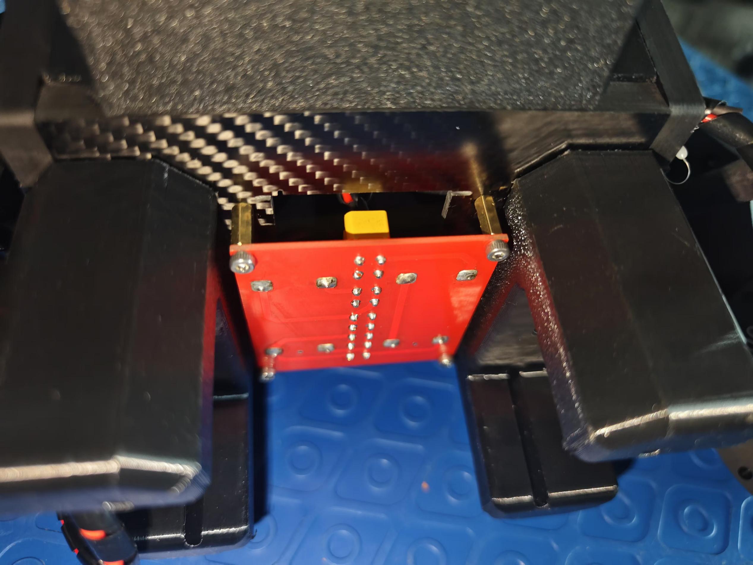
[picture p130: figure]

2 | 注意电池安装口朝向
3 | 注意螺丝涂螺纹胶

人形机器人（上海）有限公司 | 装配工艺卡 | 部件号 | | 工位号 | 共 25 页
| | 部件名称 | 中框 | | 第 20 页
工序号 | | 工序名称 | 背部控制板安装
序号 | 工作内容 | 工具名称 | 数量 | 图示
1 | 背部控制板安装两个电路板和一个模块

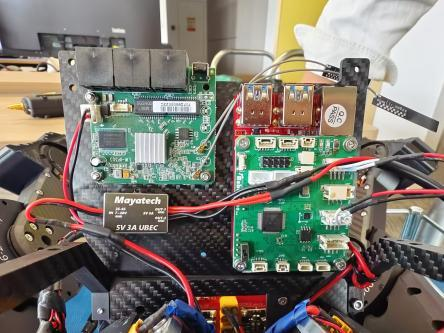
[picture p131: figure]

2 | 根据对应孔位安装
3 | 电路板插口朝上

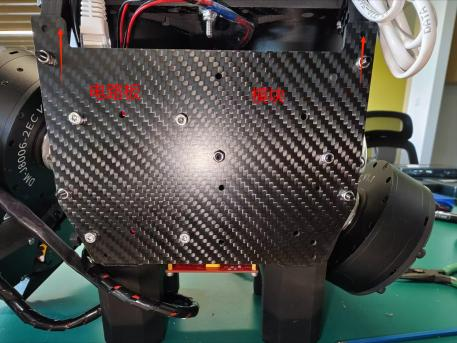
[picture p132: figure]

人形机器人（上海）有限公司 | 装配工艺卡 | 部件号 | | 工位号 | 共 25 页
| | 部件名称 | 中框 | | 第 21 页
工序号 | | 工序名称 | 背部电路板安装
序号 | 工作内容 | 工具名称 | 数量 | 图示
1 | 把电路板安装在红色塑料结构件中

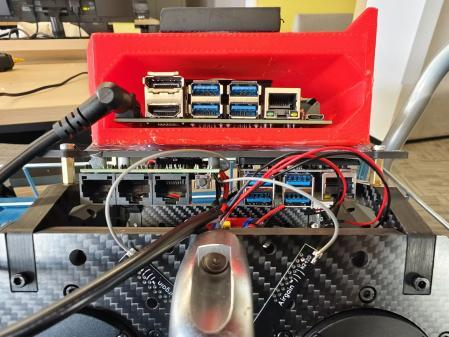
[picture p133: figure]

2 | 再把红色结构件粘贴到背板上
3 | 粘贴胶可以用 3m 纳米胶或热熔胶

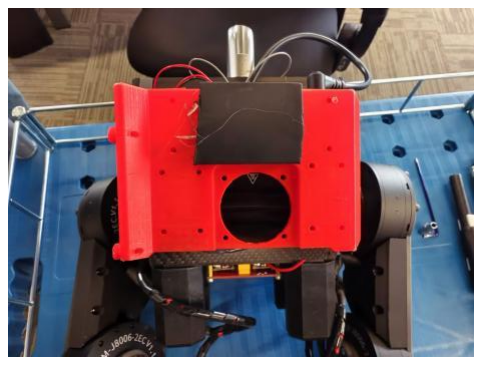
[picture p134: figure]

人形机器人（上海）有限公司 | 装配工艺卡 | 部件号 | | 工位号 | 共 25 页
| | 部件名称 | 中框 | | 第 22 页
工序号 | | 工序名称 | 正面电池安装
序号 | 工作内容 | 工具名称 | 数量 | 图示
1 | 电池安装在机器人正面

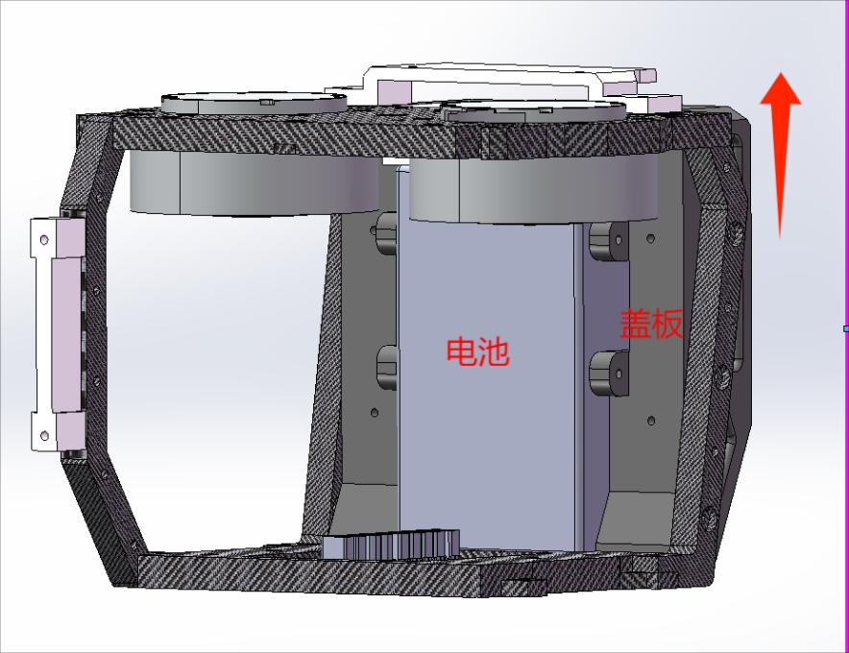
[picture p135: figure]

2 | 把电池安装在底板电池口位置
3 | 注意电池线朝上
4 | 把电池盖板安装上，左右两边螺丝锁住电池 不松动

人形机器人（上海）有限公司 | 装配工艺卡 | 部件号 | | 工位号 | 共 25 页
| | 部件名称 | 中框 | | 第 23 页
工序号 | | 工序名称 | 空气开关安装
序号 | 工作内容 | 工具名称 | 数量 | 图示
1 | 把空气开关安装到电池盖板上面缺口位置
2 | 然后上部用夹板固定空气开关

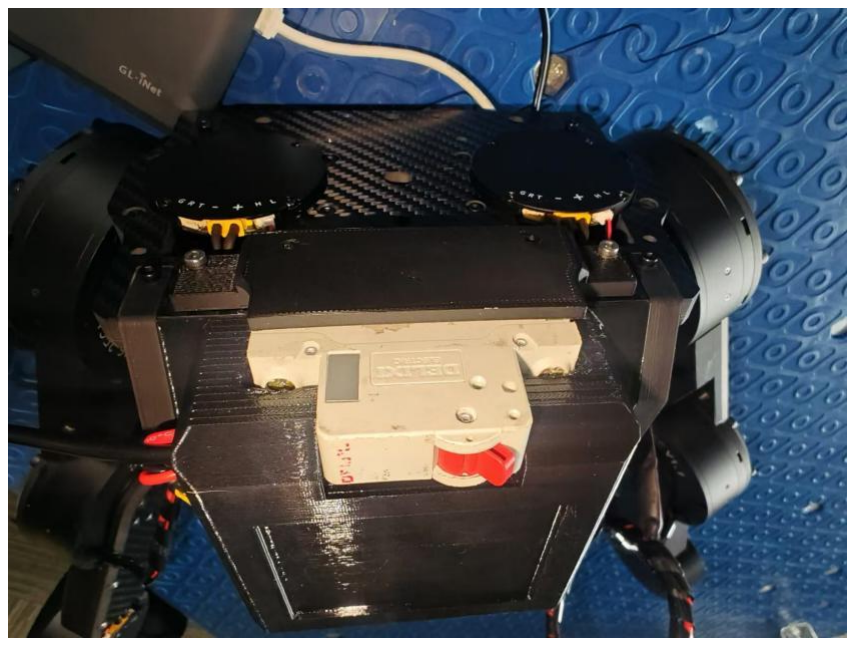
[picture p136: figure]

3 | 夹板螺丝锁紧

人形机器人（上海）有限公司 | 装配工艺卡 | 部件号 | | 工位号 | 共 25 页
| | 部件名称 | 顶部路由器把手安装 | | 第 24 页
工序号 | | 工序名称 | 顶部路由器把手安装
序号 | 工作内容 | 工具名称 | 数量 | 图示
1 | 把路由器用3m纳米胶粘贴在空气开关夹板上
2 | 把手安装在顶部结构件上部中间位置螺丝锁 紧

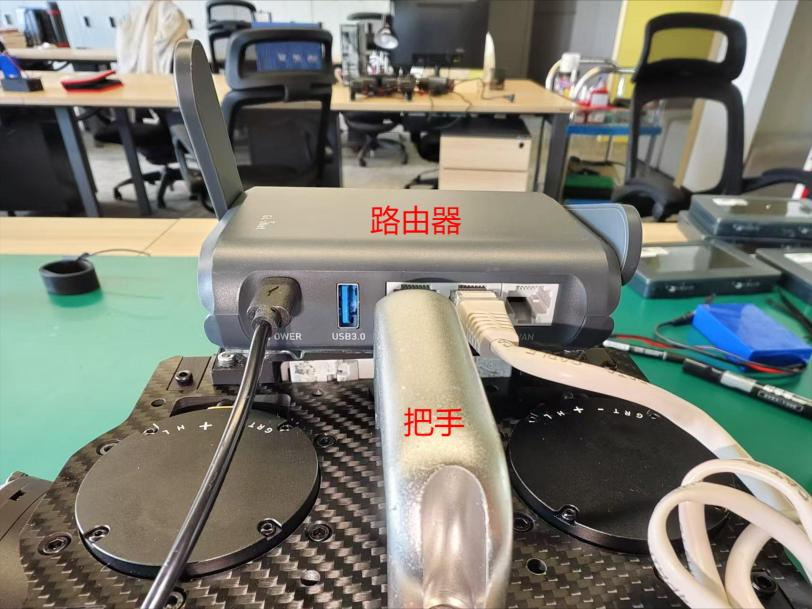
[picture p137: figure]

人形机器人（上海）有限公司 | 装配工艺卡 | 部件号 | | 工位号 | 共 25 页
| | 部件名称 | 脚 | | 第 25 页
工序号 | | 工序名称 | 脚部安装
序号 | 工作内容 | 工具名称 | 数量 | 图示
1 | 注意大腿位置结构件大角度一边朝前

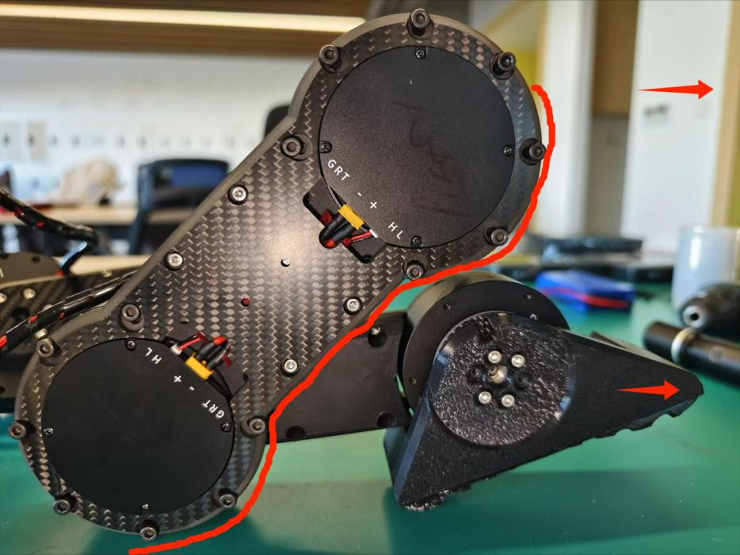
[picture p138: figure]

2 | 安装脚部塑料件
3 | 注意脚部结构件长脚趾一边是前向，注意区 分左右
