X-lanni/Tinker/5.Docs/images/assemble/ag3.jpeg

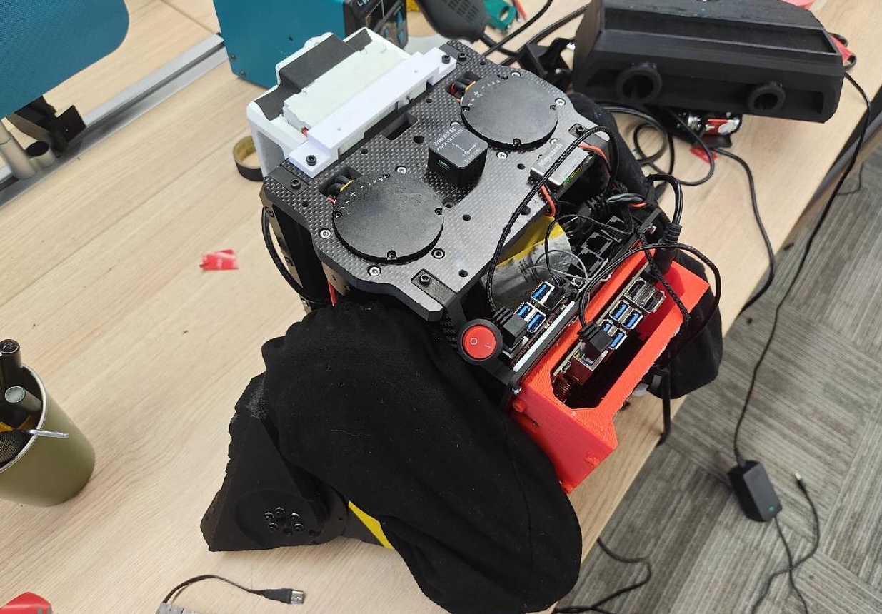
5.Docs/images/assemble/ag3.jpeg
