X-lanni/Tinker/5.Docs/images/assemble/ag4.jpeg

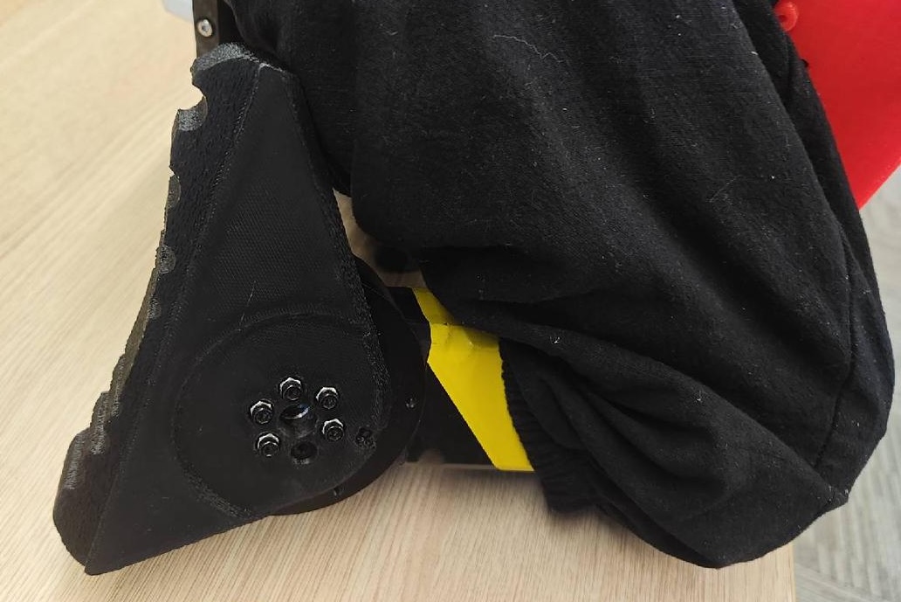
5.Docs/images/assemble/ag4.jpeg
