X-lanni/Tinker/5.Docs/images/assemble/ag5.jpeg

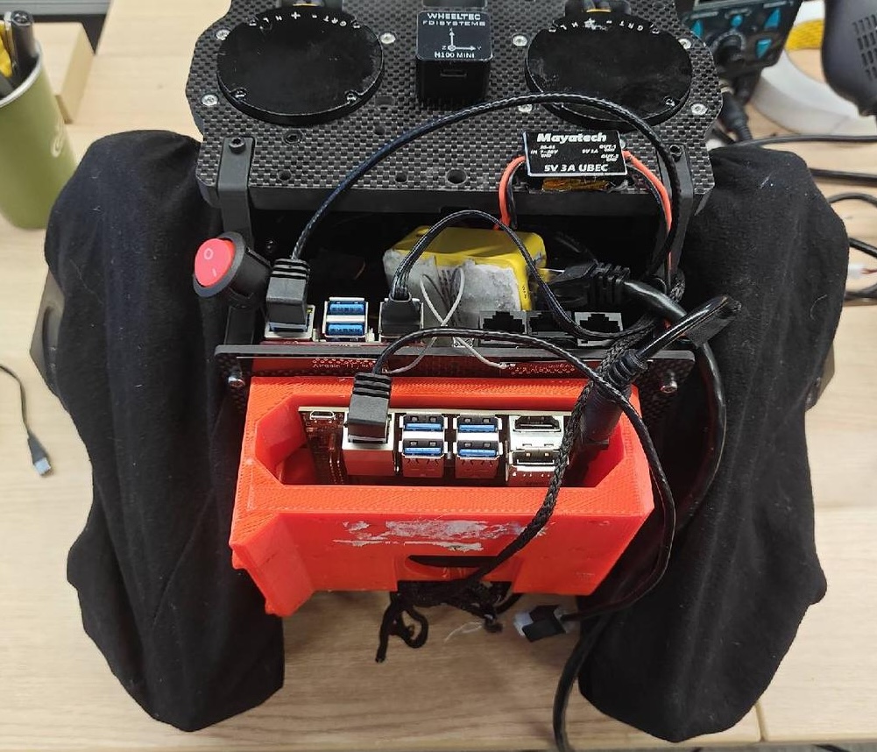
5.Docs/images/assemble/ag5.jpeg
