X-lanni/Tinker/5.Docs/images/assemble/ag6.png

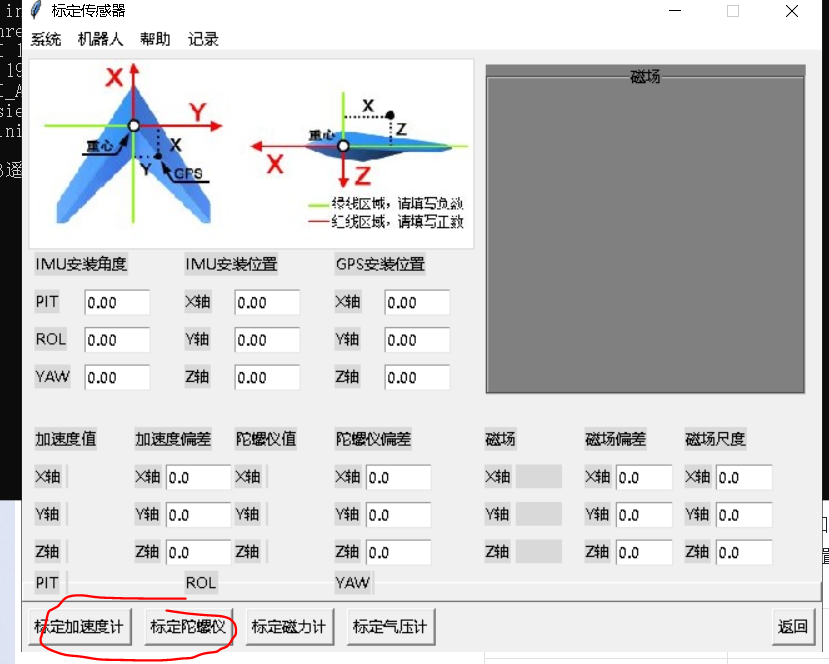
5.Docs/images/assemble/ag6.png
