X-lanni/Tinker/5.Docs/images/assemble/ag7.png

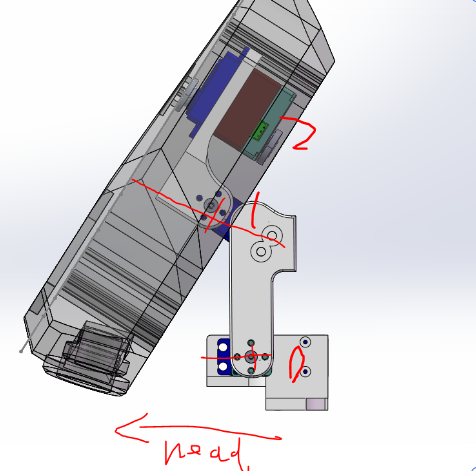
5.Docs/images/assemble/ag7.png
