X-lanni/Tinker/5.Docs/images/assemble/ag8.png

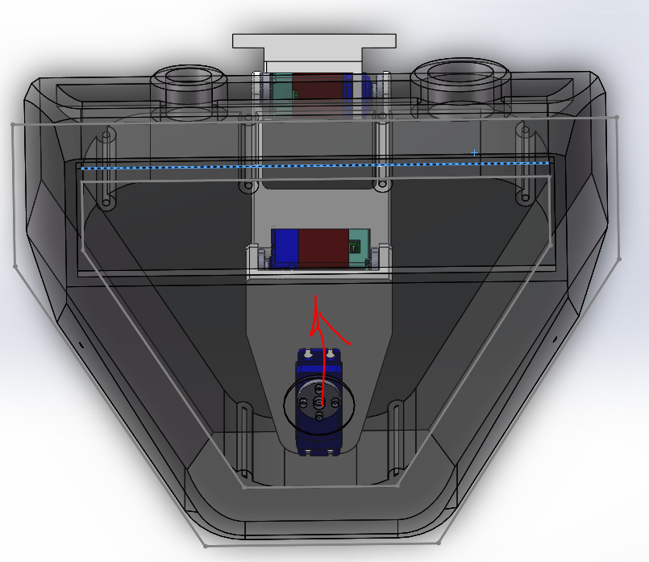
5.Docs/images/assemble/ag8.png
