X-lanni/Tinker/5.Docs/images/assemble/bm1.PNG

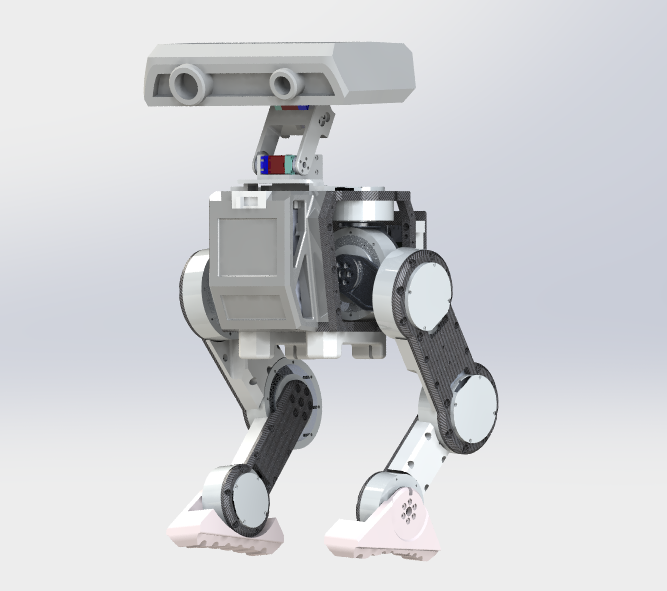
5.Docs/images/assemble/bm1.PNG
