X-lanni/Tinker/5.Docs/images/assemble/bm3.PNG

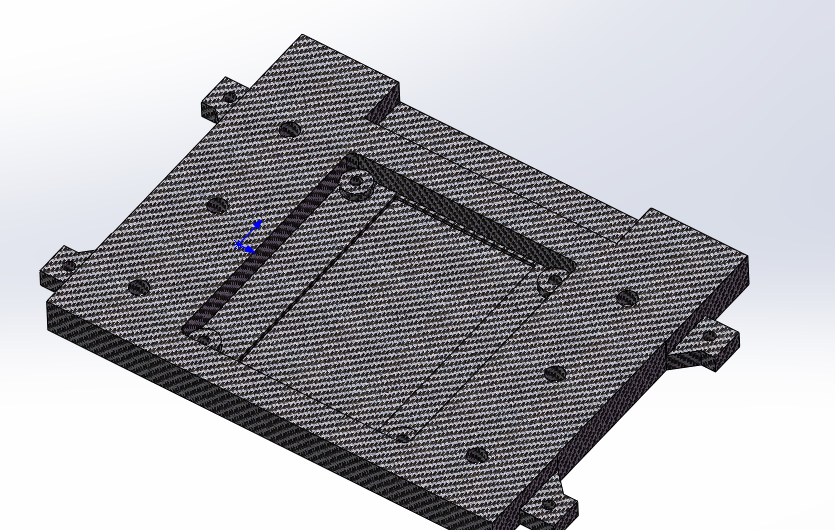
5.Docs/images/assemble/bm3.PNG
