X-lanni/Tinker/5.Docs/images/assemble/bm4.PNG

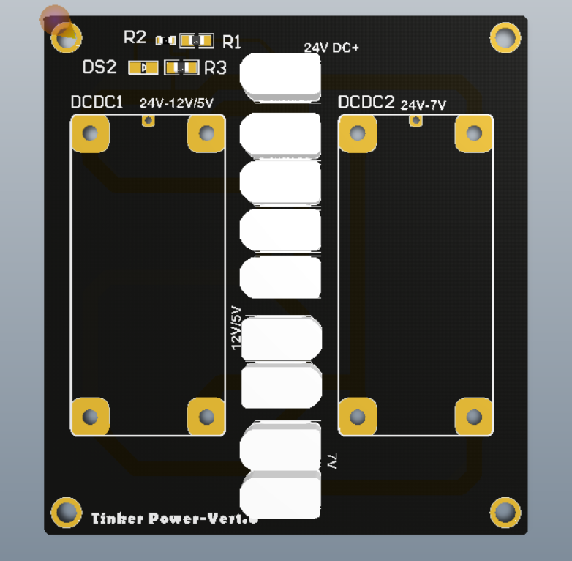
5.Docs/images/assemble/bm4.PNG
