X-lanni/Tinker/5.Docs/images/assemble/bm5.PNG

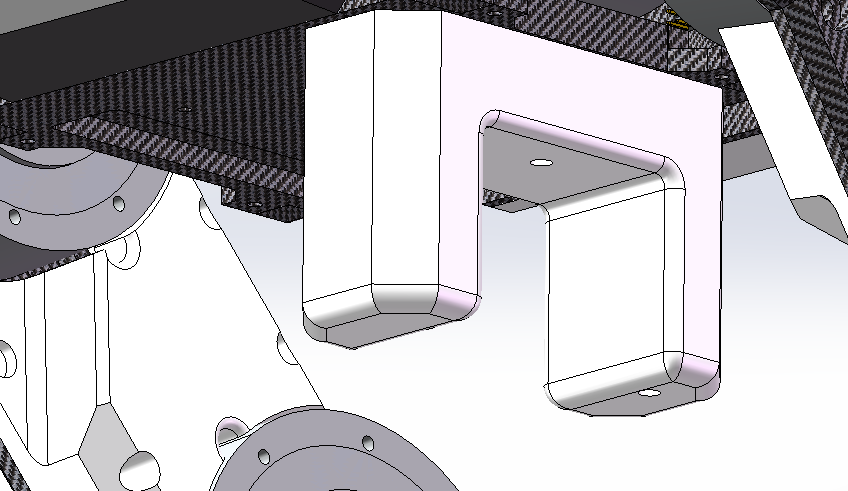
5.Docs/images/assemble/bm5.PNG
