X-lanni/Tinker/5.Docs/images/assemble/bm6.png

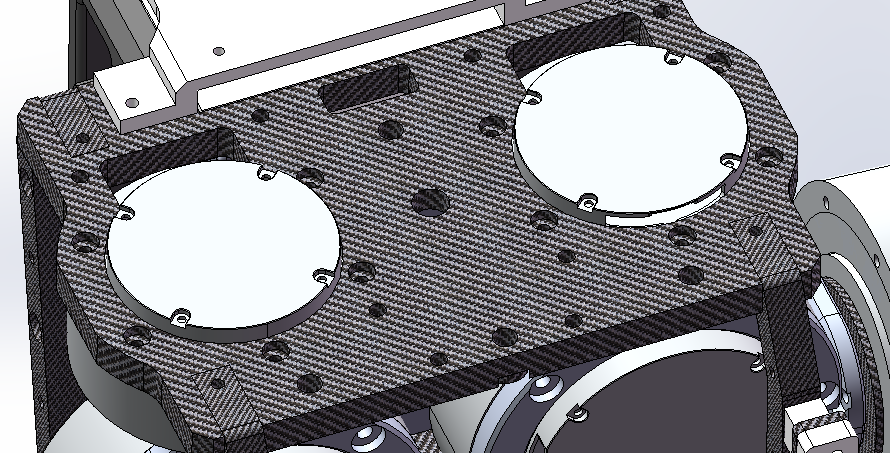
5.Docs/images/assemble/bm6.png
