X-lanni/Tinker/5.Docs/images/assemble/bm7.png

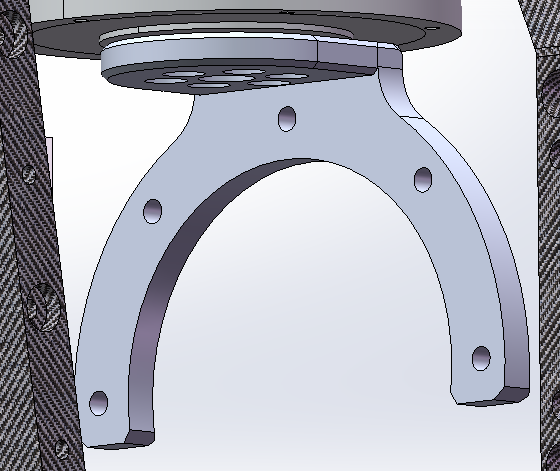
5.Docs/images/assemble/bm7.png
