X-lanni/Tinker/5.Docs/images/assemble/bm8.png

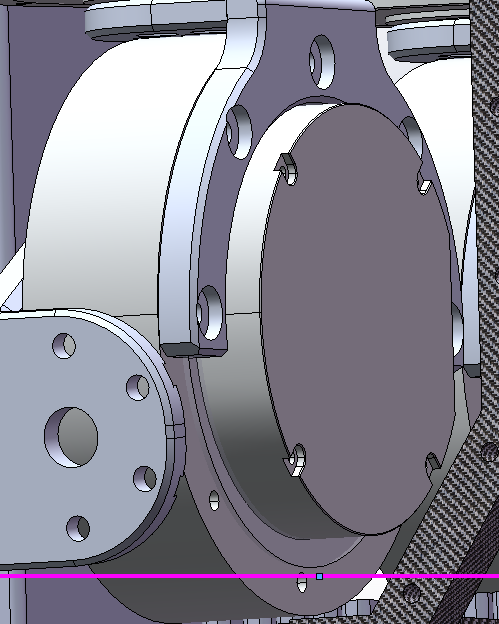
5.Docs/images/assemble/bm8.png
