X-lanni/Tinker/5.Docs/images/assemble/bm10.png

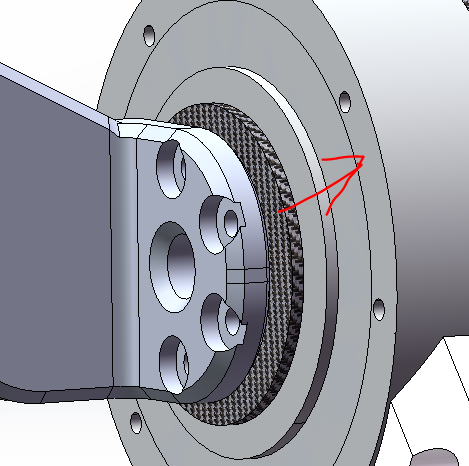
5.Docs/images/assemble/bm10.png
