X-lanni/Tinker/5.Docs/images/assemble/bm11.png

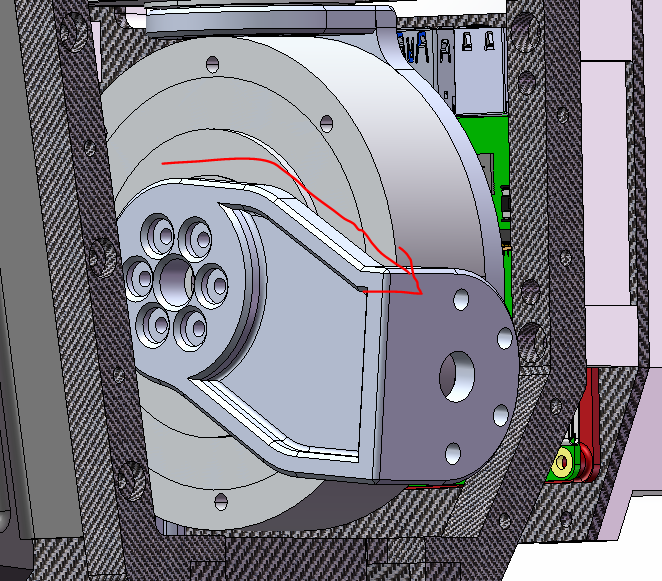
5.Docs/images/assemble/bm11.png
