X-lanni/Tinker/5.Docs/images/assemble/bm13.png

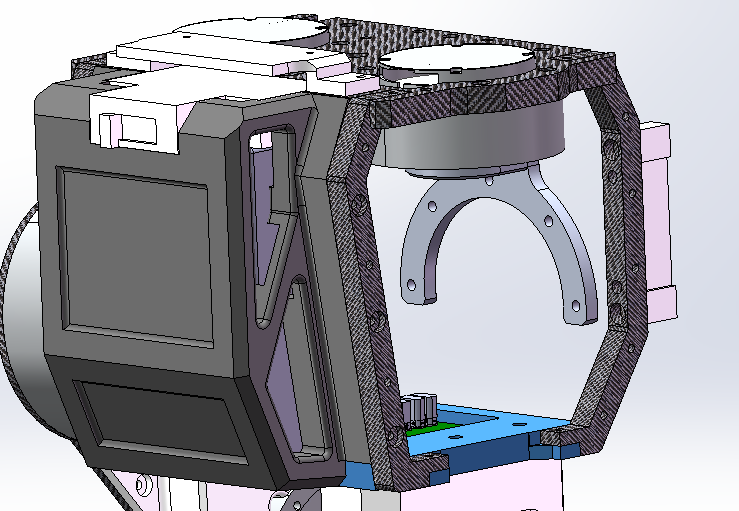
5.Docs/images/assemble/bm13.png
