X-lanni/Tinker/5.Docs/images/assemble/bm14.jpeg

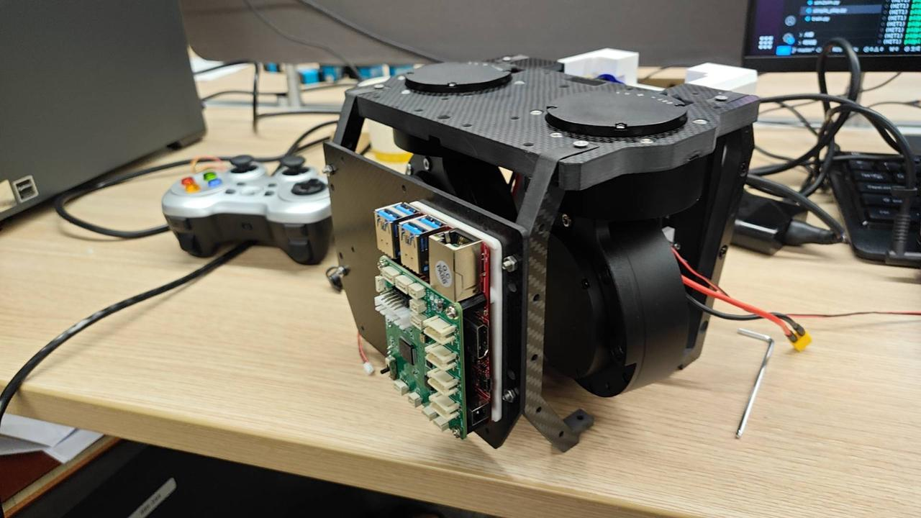
5.Docs/images/assemble/bm14.jpeg
