X-lanni/Tinker/5.Docs/images/assemble/bm15.png

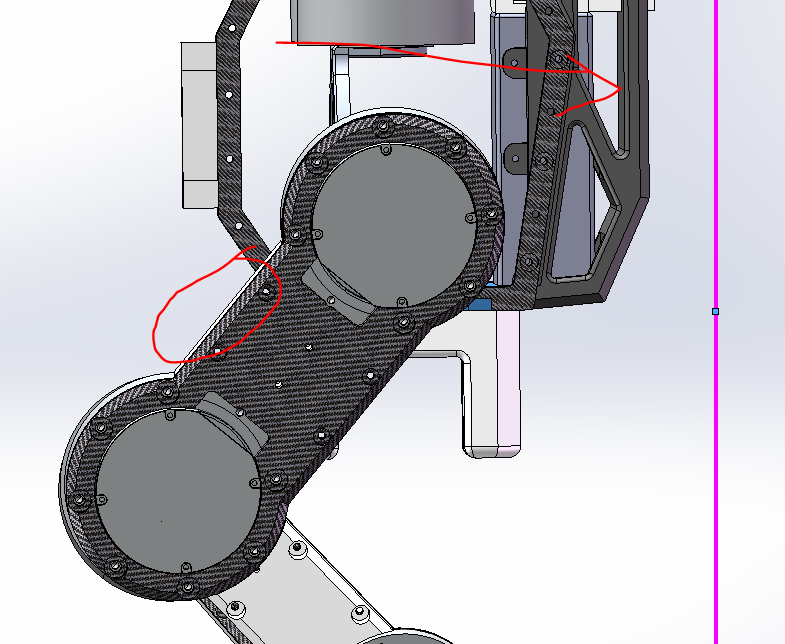
5.Docs/images/assemble/bm15.png
