X-lanni/Tinker/5.Docs/images/assemble/bm16.png

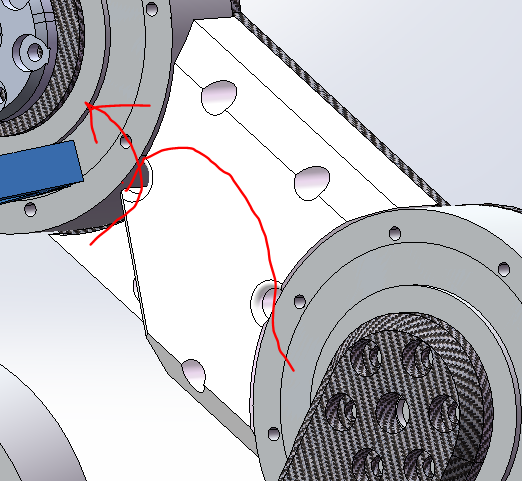
5.Docs/images/assemble/bm16.png
