X-lanni/Tinker/5.Docs/images/assemble/bm17.png

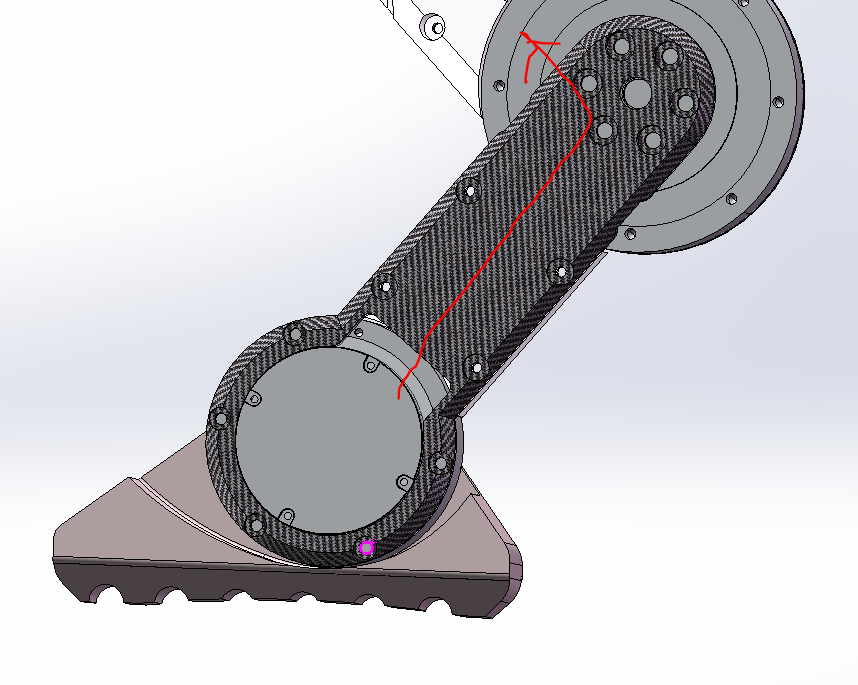
5.Docs/images/assemble/bm17.png
