X-lanni/Tinker/5.Docs/images/assemble/bm18.png

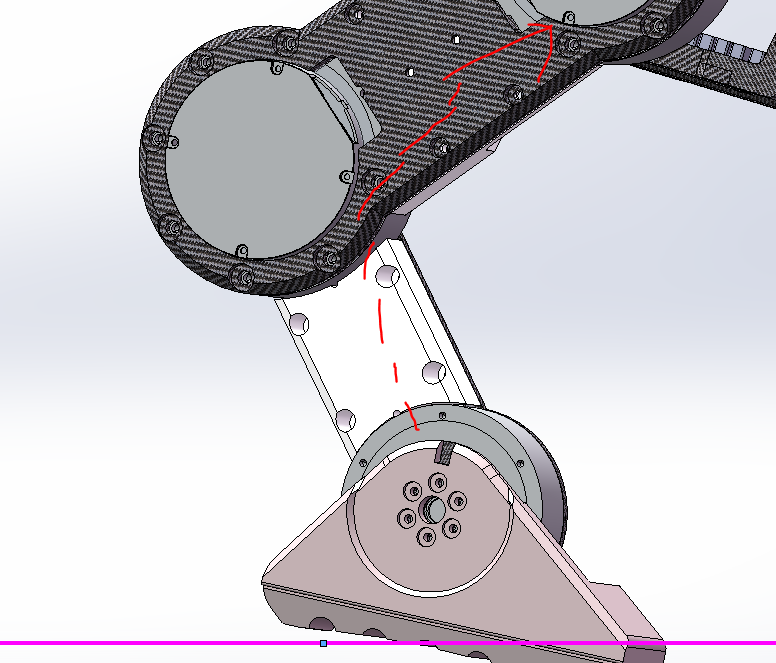
5.Docs/images/assemble/bm18.png
