X-lanni/Tinker/5.Docs/images/assemble/bm19.png

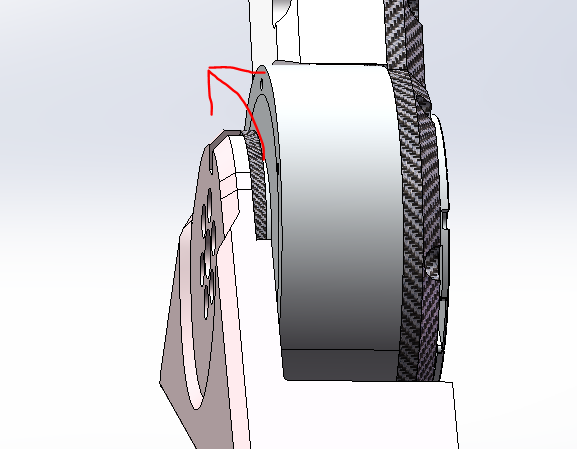
5.Docs/images/assemble/bm19.png
