X-lanni/Tinker/5.Docs/images/assemble/bm21.png

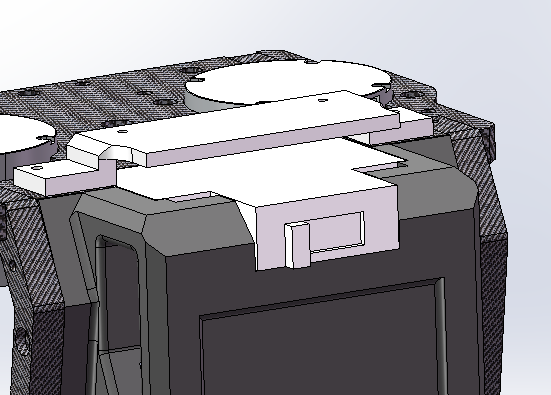
5.Docs/images/assemble/bm21.png
