X-lanni/Tinker/5.Docs/images/assemble/bm22.png

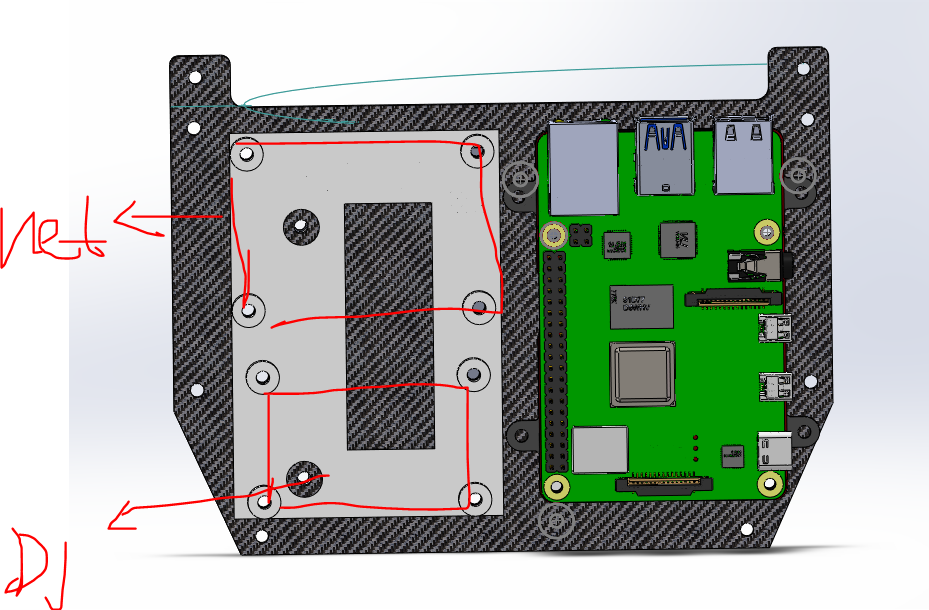
5.Docs/images/assemble/bm22.png
