X-lanni/Tinker/5.Docs/images/assemble/bm23.png

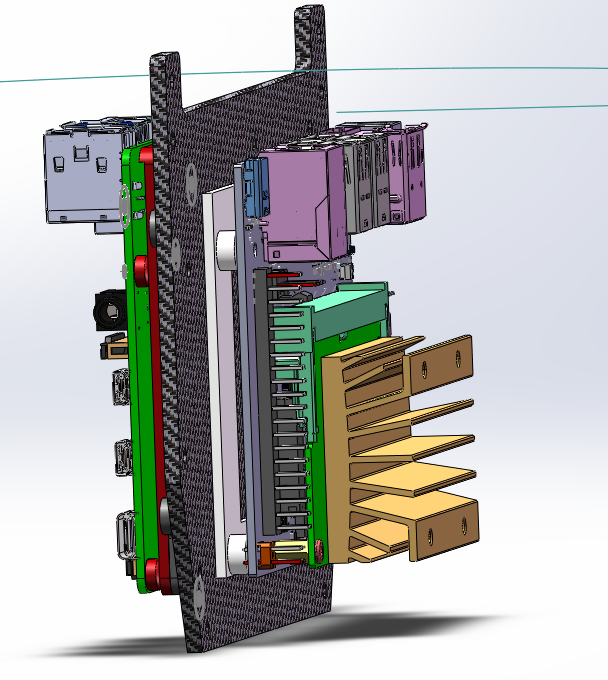
5.Docs/images/assemble/bm23.png
