X-lanni/Tinker/5.Docs/images/assemble/bm24.jpeg

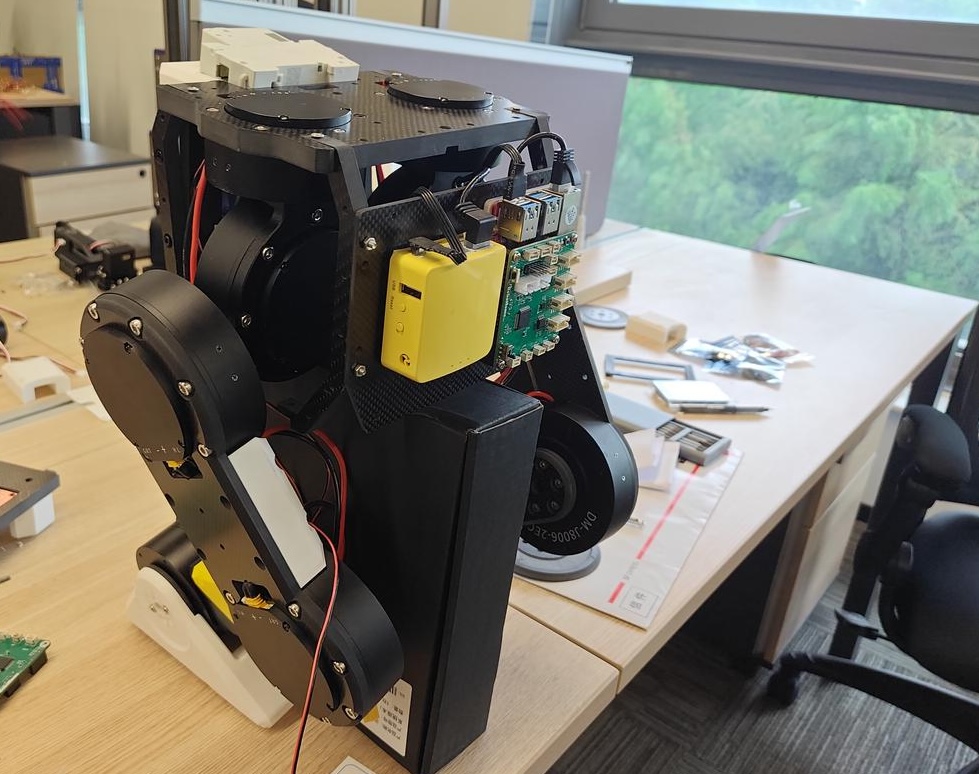
5.Docs/images/assemble/bm24.jpeg
