X-lanni/Tinker/5.Docs/images/assemble/bm24.png

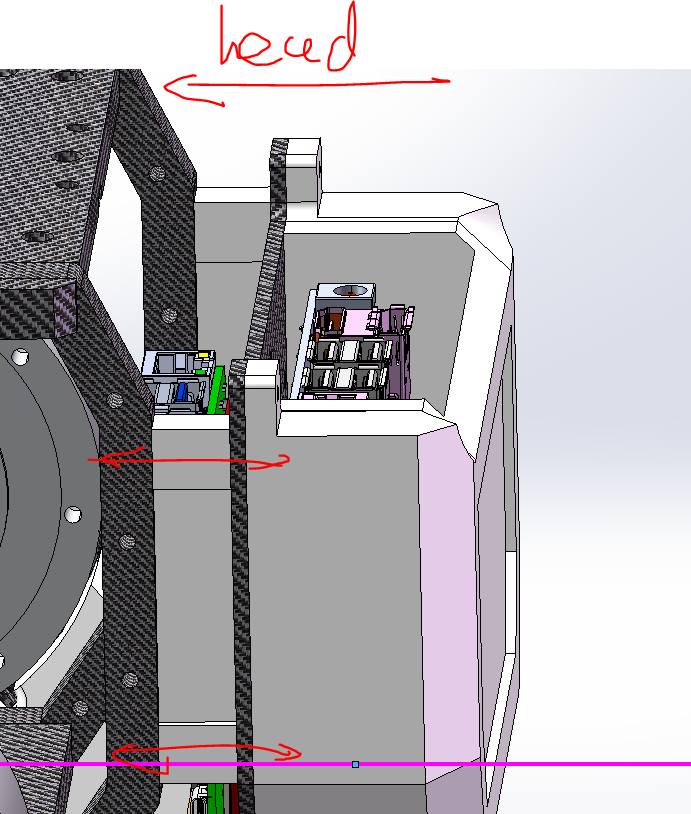
5.Docs/images/assemble/bm24.png
