X-lanni/Tinker/5.Docs/images/assemble/whiteboard_ag1.png

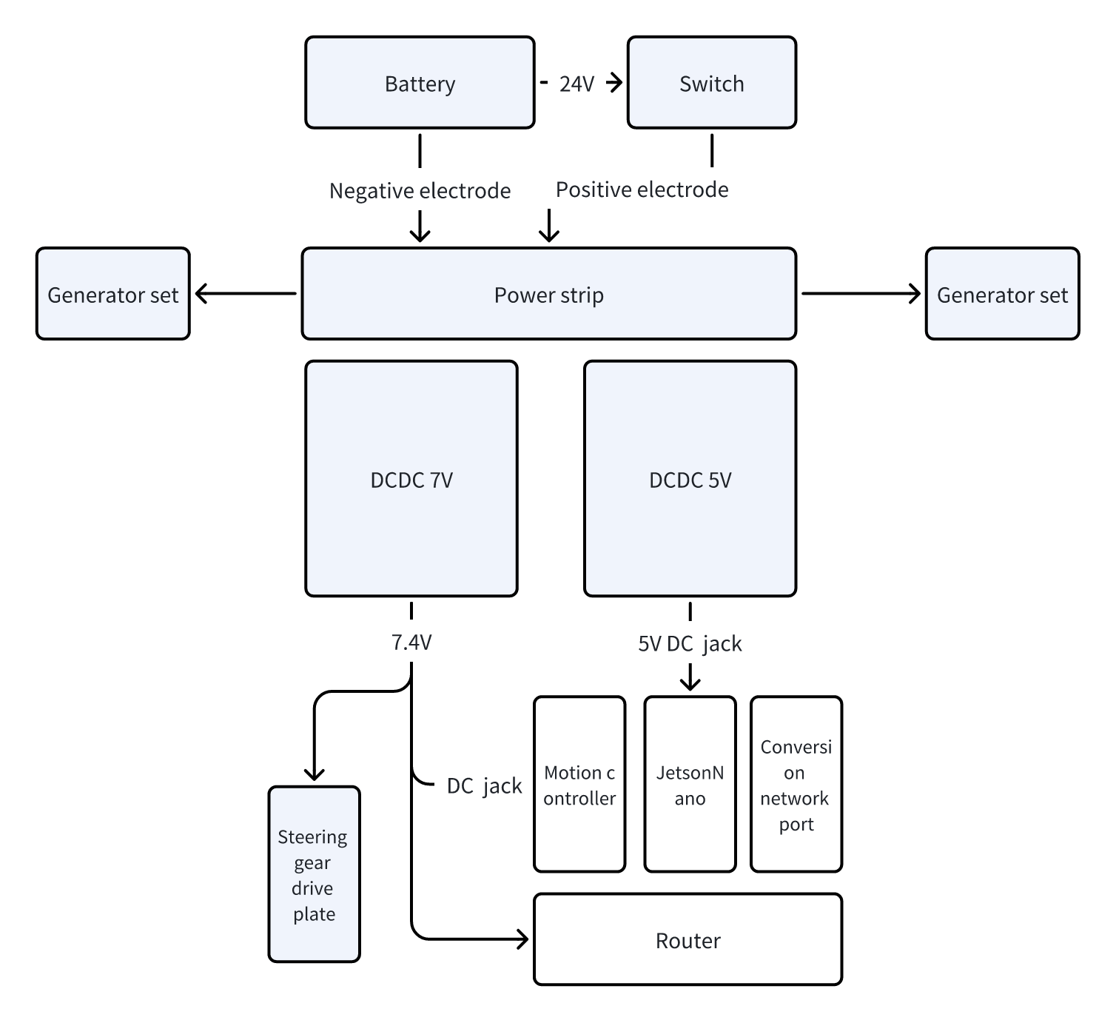
5.Docs/images/assemble/whiteboard_ag1.png
