X-lanni/Tinker/5.Docs/images/assemble/whiteboard_ag2.png

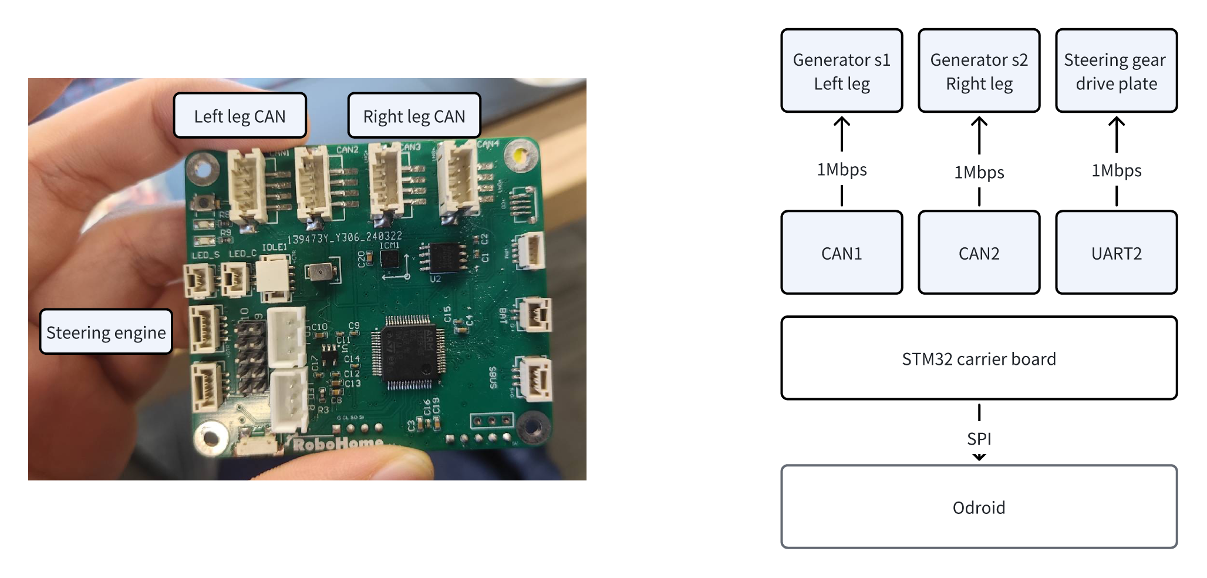
5.Docs/images/assemble/whiteboard_ag2.png
