X-lanni/Tinker/(list of files, drawings)

Other design files:
2.Assemble/Hardware/pcb原理图/PCB-20241204T155450Z-001/PCB/人形分电.PcbDoc
2.Assemble/Hardware/pcb原理图/PCB-20241204T155450Z-001/PCB/模型USB V2.PcbDoc
2.Assemble/Hardware/pcb原理图/PCB-20241204T155450Z-001/PCB/载板V2.PcbDoc
