X-lanni/Tinker/4.Development/LocomotionWithNP3O-masteroldx/lcm/lcmgen/emit_lua.c

#include <assert.h>
#include <ctype.h>
#include <fcntl.h>
#include <glib.h>
#include <inttypes.h>
#include <lcm/lcm_version.h>
#include <stdint.h>
#include <stdio.h>
#include <stdlib.h>
#include <string.h>
#include <sys/stat.h>
#include <sys/types.h>
#include <unistd.h>

#include "lcmgen.h"

// lua uses just 2 spaces per indent
#define INDENT(n) (2 * (n))

#define emit_start(n, ...)                \
    do {                                  \
        fprintf(f, "%*s", INDENT(n), ""); \
        fprintf(f, __VA_ARGS__);          \
    } while (0)
#define emit_continue(...)       \
    do {                         \
        fprintf(f, __VA_ARGS__); \
    } while (0)
#define emit_end(...)            \
    do {                         \
        fprintf(f, __VA_ARGS__); \
        fprintf(f, "\n");        \
    } while (0)
#define emit(n, ...)                      \
    do {                                  \
        fprintf(f, "%*s", INDENT(n), ""); \
        fprintf(f, __VA_ARGS__);          \
        fprintf(f, "\n");                 \
    } while (0)

#define err(...) fprintf(stderr, __VA_ARGS__)

static void mkdir_with_parents(const char *path, mode_t mode)
{
#ifdef WIN32
    g_mkdir_with_parents(path, 0755);
#else
    int len = strlen(path);
    char *dirpath = malloc(len + 1);
    for (int i = 0; i < len; i++) {
        if (path[i] == '/') {
            strncpy(dirpath, path, i);
            dirpath[i] = '\0';
            mkdir(dirpath, mode);
            i++;  // skip the '/'
        }
    }
    free(dirpath);
#endif
}

static char *build_filenamev(char **parts)
{
    char **p = parts;
    int total_len = 0;
    for (p = parts; *p; p++) {
        total_len += strlen(*p) + strlen(G_DIR_SEPARATOR_S);
    }
    total_len++;
    char *result = (char *) malloc(total_len);
    memset(result, 0, total_len);
    for (p = parts; *p; p++) {
        if (!strlen(*p))
            continue;
        strncat(result, *p, total_len);
        if (*(p + 1))
            strncat(result, G_DIR_SEPARATOR_S, total_len);
    }
    return result;
}

static void get_all_vals_helper(gpointer key, gpointer value, gpointer user_data)
{
    GPtrArray *vals = (GPtrArray *) user_data;

    g_ptr_array_add(vals, value);
}

static GPtrArray *_hash_table_get_vals(GHashTable *hash_table)
{
    GPtrArray *vals = g_ptr_array_sized_new(g_hash_table_size(hash_table));
    g_hash_table_foreach(hash_table, get_all_vals_helper, vals);
    return vals;
}

void setup_lua_options(getopt_t *gopt)
{
    getopt_add_string(gopt, 0, "lpath", "", "Lua destination directory");
    getopt_add_bool(gopt, 0, "lua-no-init", 0, "Do not create init.lua");
}

static int is_same_type(const lcm_typename_t *tn1, const lcm_typename_t *tn2)
{
    return !strcmp(tn1->lctypename, tn2->lctypename);
}

static const char *nil_initializer_string(const lcm_typename_t *type)
{
    if (!strcmp(type->lctypename, "byte"))
        return "0";
    if (!strcmp(type->lctypename, "boolean"))
        return "false";
    if (!strcmp(type->lctypename, "int8_t"))
        return "0";
    if (!strcmp(type->lctypename, "int16_t"))
        return "0";
    if (!strcmp(type->lctypename, "int32_t"))
        return "0";
    if (!strcmp(type->lctypename, "int64_t"))
        return "0";
    if (!strcmp(type->lctypename, "float"))
        return "0.0";
    if (!strcmp(type->lctypename, "double"))
        return "0.0";
    if (!strcmp(type->lctypename, "string"))
        return "''";
    else
        return "nil";
}

static char _struct_format(lcm_member_t *lm)
{
    const char *tn = lm->type->lctypename;
    if (!strcmp("byte", tn))
        return 'B';
    if (!strcmp("boolean", tn))
        return '?';
    if (!strcmp("int8_t", tn))
        return 'b';
    if (!strcmp("int16_t", tn))
        return 'h';
    if (!strcmp("int32_t", tn))
        return 'i';
    if (!strcmp("int64_t", tn))
        return 'q';
    if (!strcmp("float", tn))
        return 'f';
    if (!strcmp("double", tn))
        return 'd';
    return 0;
}

static int _primitive_type_size(const char *tn)
{
    if (!strcmp("byte", tn))
        return 1;
    if (!strcmp("boolean", tn))
        return 1;
    if (!strcmp("int8_t", tn))
        return 1;
    if (!strcmp("int16_t", tn))
        return 2;
    if (!strcmp("int32_t", tn))
        return 4;
    if (!strcmp("int64_t", tn))
        return 8;
    if (!strcmp("float", tn))
        return 4;
    if (!strcmp("double", tn))
        return 8;
    assert(0);
    return 0;
}

static char *escape_typename_to_variablename(const char *tn)
{
    char const *varname = g_strdup(tn);
    char *nameptr = (char *) varname;

    while (*nameptr != '\0') {
        if (*nameptr == '.') {
            *nameptr = '_';
        }
        ++nameptr;
    }

    return (char *) varname;
}
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
